FLRHW/Desk_controller/output/reports/Desk_controller-drc.html

Logo

(https://github.com/INTI-CMNB/KiBot/) | DRC report for Desk_controller
| PCB: Desk_controller Revision: 1.0.1 Date: 2026-10-25T19:02:43 KiCad Version: 10.0.5 | Errors: 0 Warnings: 4 Total: 4

Violations

Type | Description | Details
silk_over_copper | Silkscreen clipped by solder mask | @(197.425 mm, 77.976 mm): Segment of J6 on F.Silkscreen @(196.493 mm, 77.264 mm): Rectangle on F.Mask
silk_over_copper | Silkscreen clipped by solder mask | @(197.425 mm, 79.976 mm): Segment of J6 on F.Silkscreen @(196.493 mm, 77.264 mm): Rectangle on F.Mask
silk_over_copper | Silkscreen clipped by solder mask | @(186.925 mm, 79.976 mm): Segment of J6 on F.Silkscreen @(186.079 mm, 77.264 mm): Rectangle on F.Mask
silk_over_copper | Silkscreen clipped by solder mask | @(187.925 mm, 77.976 mm): Segment of J6 on F.Silkscreen @(186.079 mm, 77.264 mm): Rectangle on F.Mask

Generated by KiBot (https://github.com/INTI-CMNB/KiBot/) v1.9.1
