FLRHW/Desk_controller/output/reports/Desk_controller-erc.html

Logo

(https://github.com/INTI-CMNB/KiBot/) | ERC report for Desk_controller
| Schematic: Desk_controller Revision: 1.1.1 Date: 2026-10-25T19:02:39 KiCad Version: 10.0.5 | Errors: 0 Warnings: 0 Total: 0

✔

Generated by KiBot (https://github.com/INTI-CMNB/KiBot/) v1.9.1
