FLRHW/Desk_controller/output/3d/Desk_controller-3D_blenderbare_bottom.png

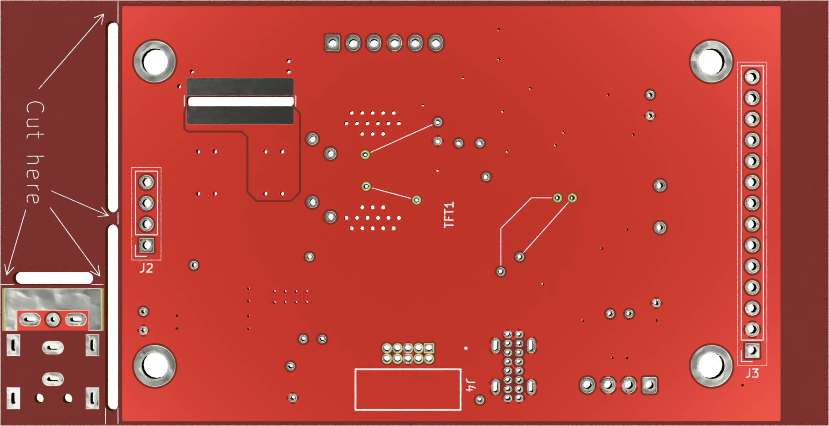
output/3d/Desk_controller-3D_blenderbare_bottom.png
