FLRHW/Desk_controller/output/3d/Desk_controller-3D_blenderbare_top.png

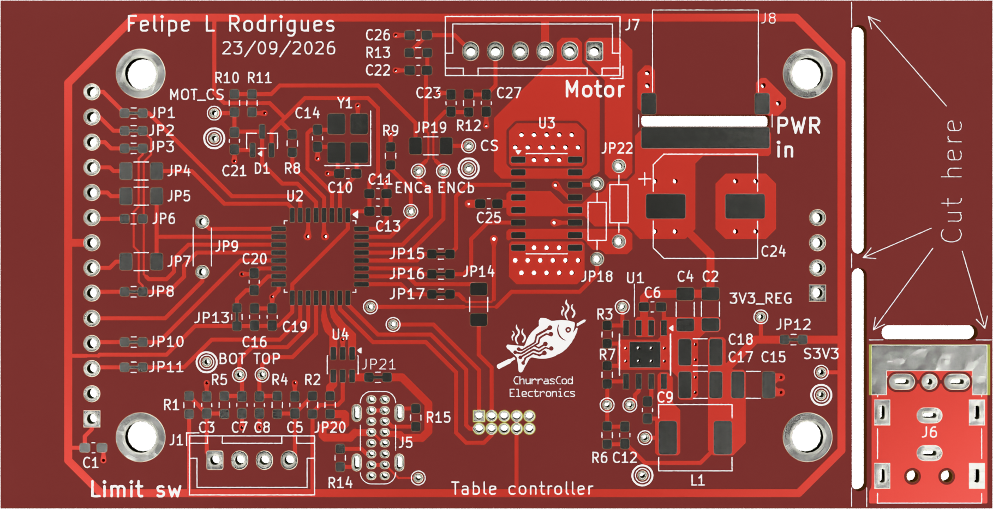
output/3d/Desk_controller-3D_blenderbare_top.png
