FLRHW/Desk_controller/output/3d/Desk_controller-3D_blenderbottom.png

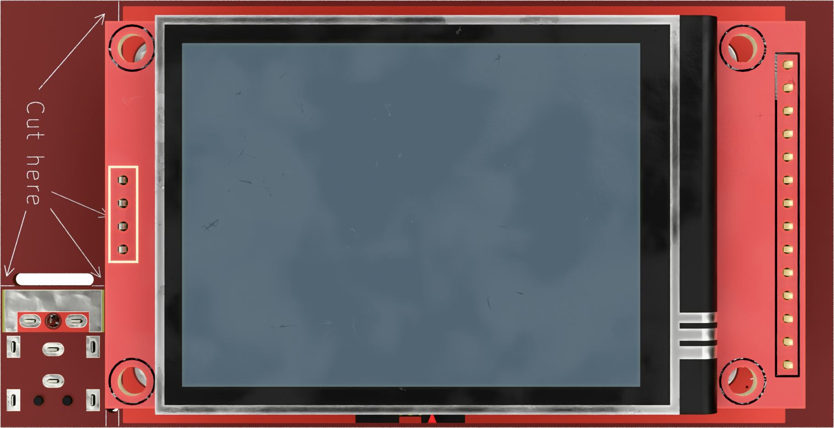
output/3d/Desk_controller-3D_blenderbottom.png
