FLRHW/Desk_controller/output/3d/Desk_controller-3D_blendertop.png

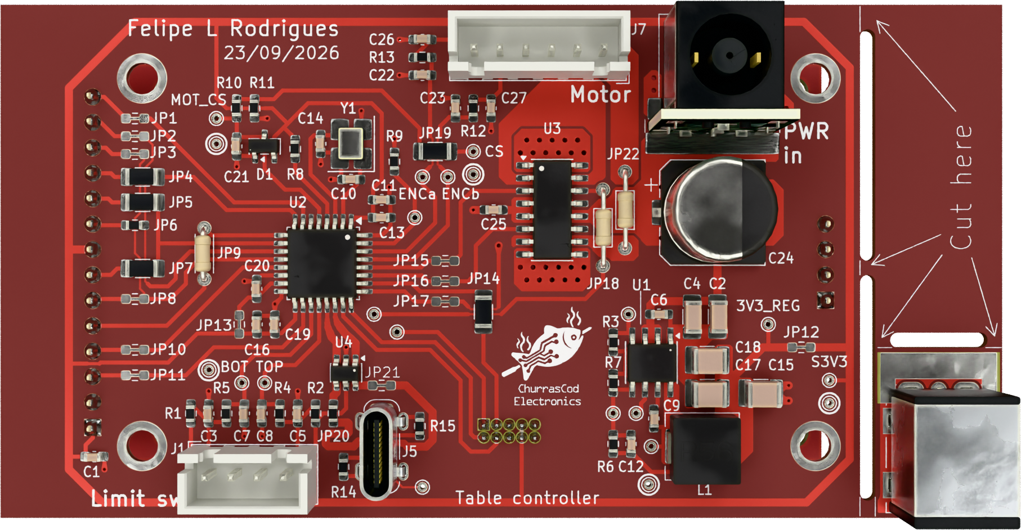
output/3d/Desk_controller-3D_blendertop.png
