FLRHW/Desk_controller/output/reports/browse/images/cat_blender_angled_bottom_Desk_controller-3D_blenderangled_bottom.png

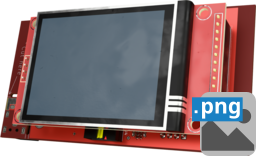
output/reports/browse/images/cat_blender_angled_bottom_Desk_controller-3D_blenderangled_bottom.png
