FLRHW/Desk_controller/output/reports/browse/images/cat_blender_bare_bottom_Desk_controller-3D_blenderbare_bottom.png

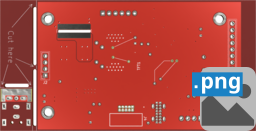
output/reports/browse/images/cat_blender_bare_bottom_Desk_controller-3D_blenderbare_bottom.png
