FLRHW/Desk_controller/output/reports/browse/images/cat_blender_bottom_Desk_controller-3D_blenderbottom.png

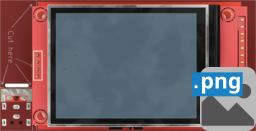
output/reports/browse/images/cat_blender_bottom_Desk_controller-3D_blenderbottom.png
