FLRHW/Desk_controller/output/reports/browse/images/cat_Schematic_Desk_controller-schematic.png

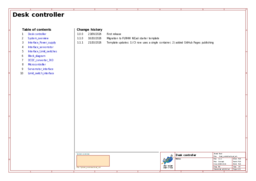
output/reports/browse/images/cat_Schematic_Desk_controller-schematic.png
