FLRHW/Desk_controller/output/reports/browse/images/cat_schematic_pdf_Desk_controller-schematic.png

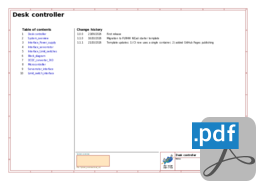
output/reports/browse/images/cat_schematic_pdf_Desk_controller-schematic.png
