FLRHW/Desk_controller/output/assembly/bom/Desk_controller-bom.xlsx

Sheet: BoM
 |  | KiBot Bill of Materials
 |  | Schematic: | Desk_controller | Component Groups: | 39
 |  | Variant: | default | Component Count: | 72
 |  | Revision: | 1.1.1 | Fitted Components: | 72
 |  | Date: | 21/10/2026 | Number of PCBs: | 1
 |  | KiCad Version: | 10.0.5-unknown-202607221313~667fa36054~ubuntu25.10.1 | Total Components: | 72
Row | Description | Part | References | Value | Footprint | Quantity Per PCB | Status | Datasheet | Manufacturer | Manufacturer Part Number | Assy | BarrelConn | Config | Field5
1 | Unpolarized capacitor | C | C10 C14 | 22p | C_0603_1608Metric_Pad1.08x0.95mm_HandSolder | 2 |  |  | Yageo | AC0603JRNPO9BN220
2 | Unpolarized capacitor | C | C12 | 33p | C_0603_1608Metric_Pad1.08x0.95mm_HandSolder | 1 |  |  | Yageo | AC0603JRNPO9BN330
3 | Unpolarized capacitor | C | C7 C8 C21 C22 C23 | 1n | C_0603_1608Metric_Pad1.08x0.95mm_HandSolder | 5 |  |  | Yageo | AC0603KRX7R9BB102
4 | Unpolarized capacitor | C | C3 C5 C26 C27 | 10n | C_0603_1608Metric_Pad1.08x0.95mm_HandSolder | 4 |  |  | Yageo | AC0603KRX7R9BB103
5 | Unpolarized capacitor | C | C1 C6 C9 C13 C19 C20 C25 | 100n | C_0603_1608Metric_Pad1.08x0.95mm_HandSolder | 7 |  |  | Yageo | AC0603KRX7R9BB104
6 | Unpolarized capacitor | C | C11 C16 | 1u | C_0603_1608Metric_Pad1.08x0.95mm_HandSolder | 2 |  |  | Yageo | AC0603KRX7R7BB105
7 | Unpolarized capacitor | C | C2 C4 | 4.7u | C_1206_3216Metric_Pad1.33x1.80mm_HandSolder | 2 |  |  | KEMET | C1206C475K5RACAUTO
8 | Unpolarized capacitor | C | C15 C17 C18 | 22u | C_1210_3225Metric_Pad1.33x2.70mm_HandSolder | 3 |  |  | TAIYO YUDEN | MCAST32MSB7226KPNA01
9 | Polarized capacitor | C_Polarized | C24 | 220u | CP_Elec_10x10 | 1 |  |  | Panasonic | EEE-FK1H221P
10 | BAV99 High-speed switching diodes, SOT-23 | BAV99 | D1 | BAV99 | SOT-23 | 1 |  | https://assets.nexperia.com/documents/data-sheet/BAV99_SER.pdf | Diodes Inc | BAV99Q-7-F
11 | Generic connector, single row, 01x04, script generated | Conn_01x04_Pin | J2 | 01x04 socket | PinSocket_1x04_P2.54mm_Vertical | 1 |  |  | Generic | Generic
12 | Generic connector, single row, 01x14, script generated | Conn_01x14_Pin | J3 | 01x14 socket | PinSocket_1x14_P2.54mm_Vertical | 1 |  |  | Generic | Generic
13 | Generic connector, single row, 01x04, script generated | Conn_01x04_Pin | J1 | B4B XH A | JST_XH_B4B-XH-A_1x04_P2.50mm_Vertical | 1 |  |  | JST | B4B XH A
14 | Generic connector, single row, 01x06, script generated | Conn_01x06_Pin | J7 | B6B XH A | JST_XH_B6B-XH-A_1x06_P2.50mm_Vertical | 1 |  |  | JST | B6B XH A
15 |  | DC_barrel_assy | J8 | DC barrel assy | Dell_barrel_assy | 1 |  |  | NA | NA
16 |  | Dell_DC_barrel_jack | J6 | Dell DC jack | Dell DC jack | 1 |  |  | Dell | Barrel jack
17 | Generic connector, double row, 02x05, odd/even pin numbering scheme (row 1 odd numbers, row 2 even numbers), script generated (kicad-library-utils/schlib/autogen/connector/) | Conn_02x05_Odd_Even | J4 | HX JN1.27-2x5 WZ H4.9 | JN1.27-2x5 WZ H4.9 | 1 |  |  | Hanxia | HX JN1.27-2x5 WZ H4.9 |  |  |  | https://www.lcsc.com/product-detail/IDC-Connectors_hanxia-HX-JN1-27-2x5-WZ-H4-9_C42372551.html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
18 | USB 2.0-only 16P Type-C Receptacle connector | USB_C_Receptacle_USB2.0_16P | J5 | USB_C_Receptacle_USB2.0_16P | USB_C_socket_16P_vertical | 1 |  | https://www.usb.org/sites/default/files/documents/usb_type-c.zip | ChengHaoRan | TFKH5-16L4CC-65
19 | Jumper | R | JP4 JP5 JP7 JP14 JP19 | 0R | R_1206_3216Metric_Pad1.30x1.75mm_HandSolder | 5 |  |  | NA | Hand cut wire
20 | Jumper | R | JP18 JP22 | 0R | R_Axial_DIN0204_L3.6mm_D1.6mm_P7.62mm_Horizontal | 2 |  |  | NA | Hand cut wire
21 | Jumper | R | JP6 JP20 | 0R | R_0603_1608Metric_Pad0.98x0.95mm_HandSolder | 2 |  |  | Yageo | RC0603JR-130RP
22 | Jumper | R | JP23 | 0R | Wire_9.603mm | 1 |  |  | NA | Hand cut wire
23 | Jumper | R | JP24 | 0R | Wire_6.310mm | 1 |  |  | NA | Hand cut wire
24 | Jumper | R | JP25 | 0R | Wire_9.532mm | 1 |  |  | NA | Hand cut wire
25 | Jumper | R | JP26 | 0R | Wire_6.853x8.890mm | 1 |  |  | NA | Hand cut wire
26 | Jumper | R | JP9 | 0R | R_Axial_DIN0204_L3.6mm_D1.6mm_P5.08mm_Horizontal | 1 |  |  | NA | Hand cut wire
27 | Inductor | L | L1 | 10u | L_Bourns_SRP6540 | 1 |  |  | Bourns | SRP6540-100M
28 | Resistor | R | R11 | 820 | R_0603_1608Metric_Pad0.98x0.95mm_HandSolder | 1 |  |  | YAGEO | AC0603FR-07820RL
29 | Resistor | R | R4 R5 R10 R12 R13 | 2k2 | R_0603_1608Metric_Pad0.98x0.95mm_HandSolder | 5 |  |  | YAGEO | AC0603FR-072K2L
30 | Resistor | R | R14 R15 | 5k1 | R_0603_1608Metric_Pad0.98x0.95mm_HandSolder | 2 |  |  | YAGEO | AC0603FR-075K1L
31 | Resistor | R | R1 R2 R7 R8 R9 | 10k | R_0603_1608Metric_Pad0.98x0.95mm_HandSolder | 5 |  |  | YAGEO | AC0603FR-0710KL
32 | Resistor | R | R6 | 23.2k | R_0603_1608Metric_Pad0.98x0.95mm_HandSolder | 1 |  |  | YAGEO | AC0603FR-0723K2L
33 | Resistor | R | R3 | 64.9k | R_0603_1608Metric_Pad0.98x0.95mm_HandSolder | 1 |  |  | YAGEO | AC0603FR-0764K9L
34 |  | TFT_2.8_IN_320x240 | TFT1 | TFT_2.4in_320x240 | Display_240x320_ILI9341_2.4in_no_pads | 1 |  |  | TENSTAR ROBOT | ILI9341_320x240
35 |  | LMR380x0 | U1 | LMR380x0 | Texas_HSOP-8-1EP_3.9x4.9mm_P1.27mm_ThermalVias_w_step | 1 |  |  | Texas instruments | LMR38020FDDAR
36 | STMicroelectronics Arm Cortex-M4 MCU, 64KB flash, 32KB RAM, 170 MHz, 1.71-3.6V, 26 GPIO, LQFP32 | STM32G431K8Tx | U2 | STM32G431K8T | LQFP-32_7x7mm_P0.8mm | 1 |  | https://www.st.com/resource/en/datasheet/stm32g431k8.pdf | ST | STM32G431K8T6
37 | Very low capacitance ESD protection diode, 2 data-line, SOT-23-6 | USBLC6-2SC6 | U4 | USBLC6-2SC6 | SOT-23-6 | 1 |  | https://www.st.com/resource/en/datasheet/usblc6-2.pdf | ST | USBLC6-2SC6
38 |  | VNH7070 | U3 | VNH7070 | JEITA_SOIC-16_3.9x9.9mm_P1.27mm | 1 |  |  | ST | VNH7070
39 | Four pin crystal, GND on pins 2 and 4, small symbol | Crystal_GND24_Small | Y1 | 20 MHz | Crystal_SMD_3225-4Pin_3.2x2.5mm_HandSoldering | 1 |  |  | KYOCERA AVX | CX3225SB20000H0FLJCC

Sheet: Colors
Columns colors
KiCad Fields (default)
Generated Fields
User Fields
Empty Fields
