FLRHW/Desk_controller/output/3d/Desk_controller-3D.step

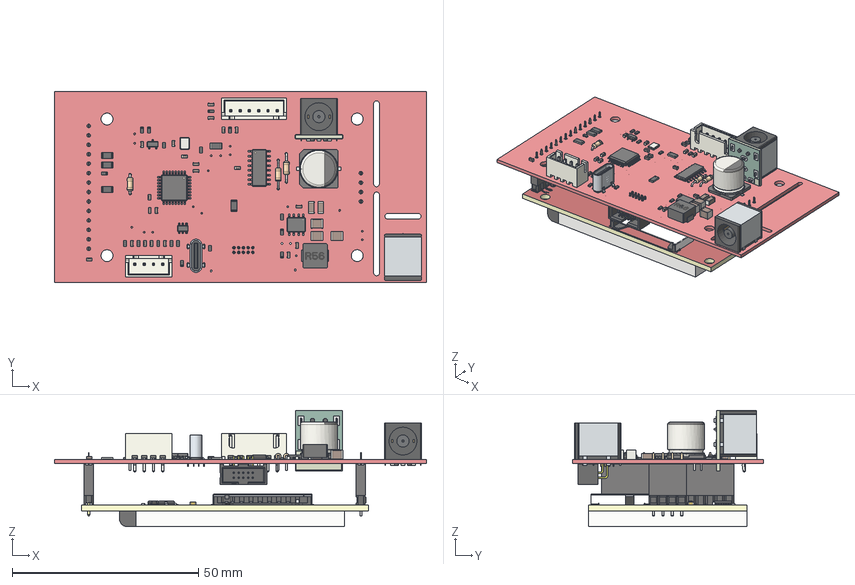
[picture p18: CAD file, 2026-10-25]
output/3d/Desk_controller-3D.step
100.0 x 51.2 x 31.2 mm
R_1206_3216Metric x 5
C_0603_1608Metric x 21
R_0603_1608Metric x 17
C_1210_3225Metric x 3
black_plastic_body x 2
contiguous_stamped_shield_and_four_stakes x 2
plastic_centre_boss_with_ID_hole x 2
barrel_side_contact_1 x 2
barrel_side_contact_2 x 2
pad1_terminal_1_x-2.775_y12.25 x 2
pad1_terminal_2_x2.775_y12.25 x 2
pad2_terminal_3_x0_y12.25 x 2
pad3_terminal_4_x0_y8.85 x 2
pad3_terminal_5_x0_y5.05 x 2
plastic_peg_1 x 2
plastic_peg_2 x 2
SOT-23-6
JST_B4B_XH_A
Texas_HTSOP_8_1EP_39x49mm_P127mm_EP285x49mm_Mask24x31mm_ThermalVias
R_Axial_DIN0204_L36mm_D16mm_P762mm_Horizontal x 2
SOP-16_3.9x9.9mm_P1.27mm
C_1206_3216Metric x 2
Crystal_SMD_3225-4Pin_3.2x2.5mm
SOT-23
CP_Elec_10x10
R_Axial_DIN0204_L36mm_D16mm_P508mm_Horizontal
Barrel-unsaved-export-6gLF2A_pad
Barrel-unsaved-export-6gLF2A_silkscreen
Barrel-unsaved-export-6gLF2A_soldermask x 2
Barrel-unsaved-export-6gLF2A_PCB
SRP6540
JST_B6B_XH_A
stainless_shell
black_LCP_body_and_tongue
contact_r1_c1
contact_r1_c2
contact_r1_c3
contact_r1_c4
contact_r1_c5
contact_r1_c6
contact_r1_c7
contact_r1_c8
contact_r2_c1
contact_r2_c2
contact_r2_c3
contact_r2_c4
contact_r2_c5
contact_r2_c6
contact_r2_c7
contact_r2_c8
mating_contact_A1
mating_contact_A2
mating_contact_A3
mating_contact_A4
mating_contact_A5
mating_contact_A6
mating_contact_A7
mating_contact_A8
mating_contact_A9
mating_contact_A10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
