FLRHW/Desk_controller/output/fabrication/Desk_controller-pcb-fabrication.pdf

# Desk controller fabrication drawing

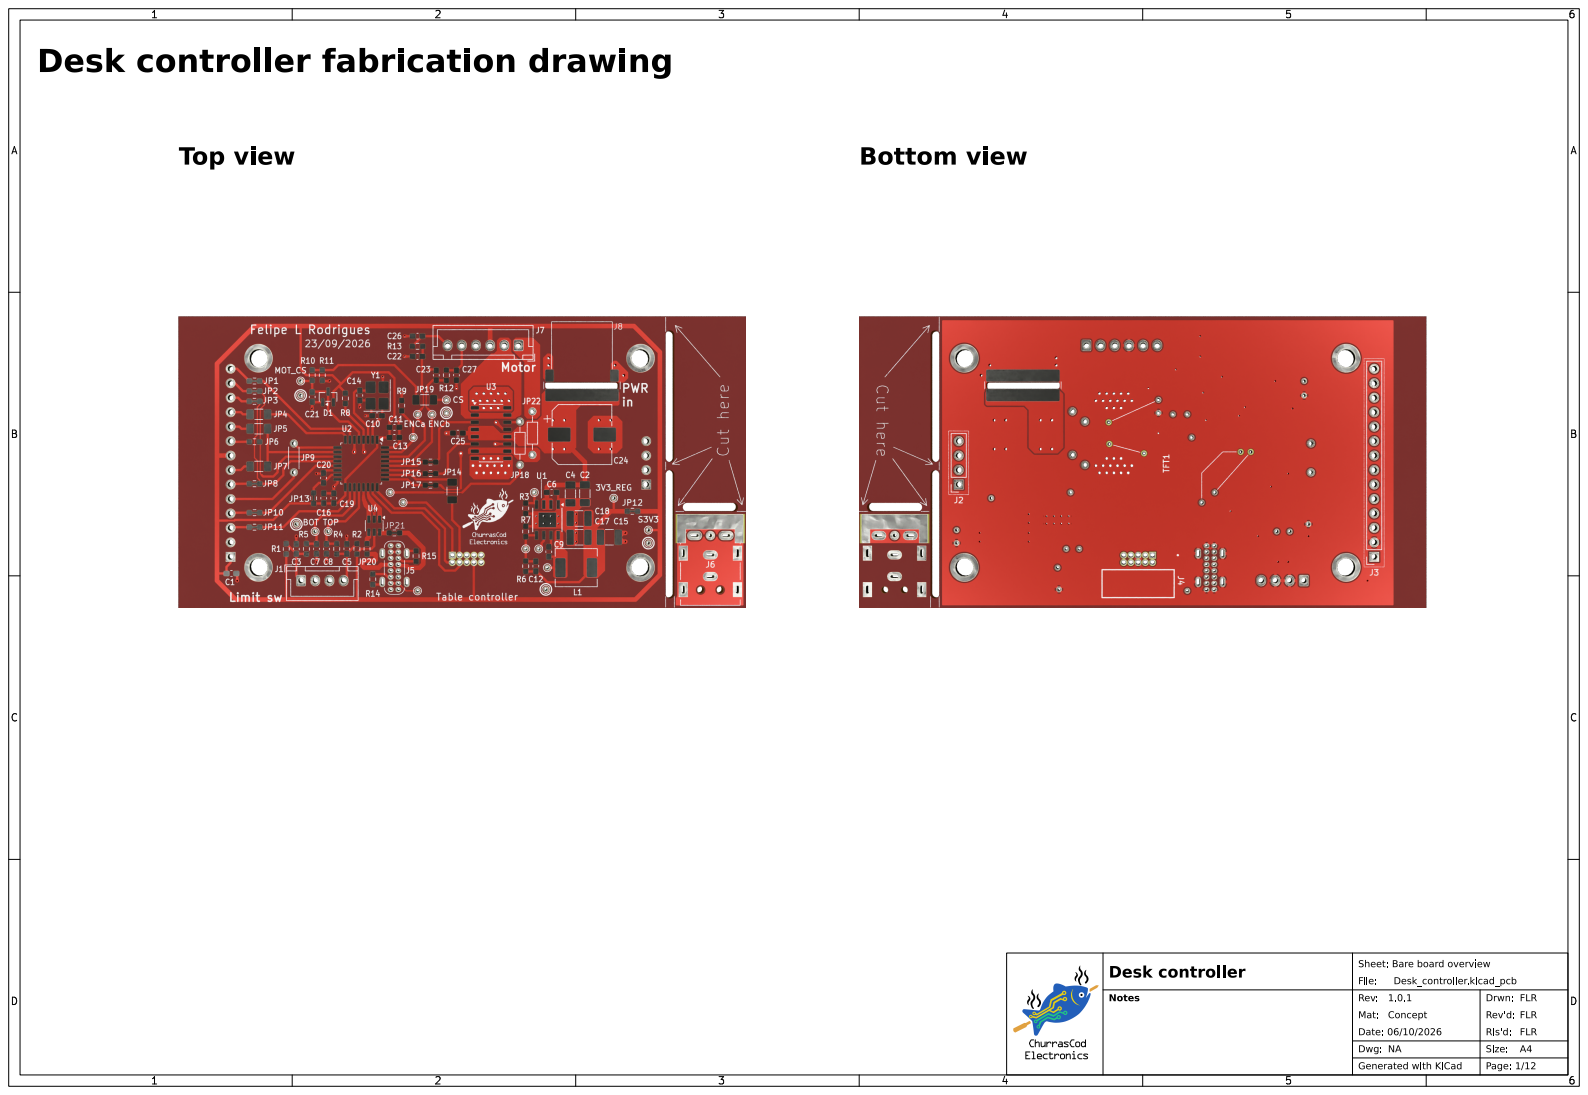
[picture p26: page 1]
Desk_controller.kicad_pcb; FLR; Rev'd:; Drwn:; Desk controller; Rls'd:; Concept; Notes; Size:

Sheet: Bare board overview
File:
Rev:
Mat:
Date: 06/10/2026
Dwg: NA
Generated with KiCad

# Fabrication requirements

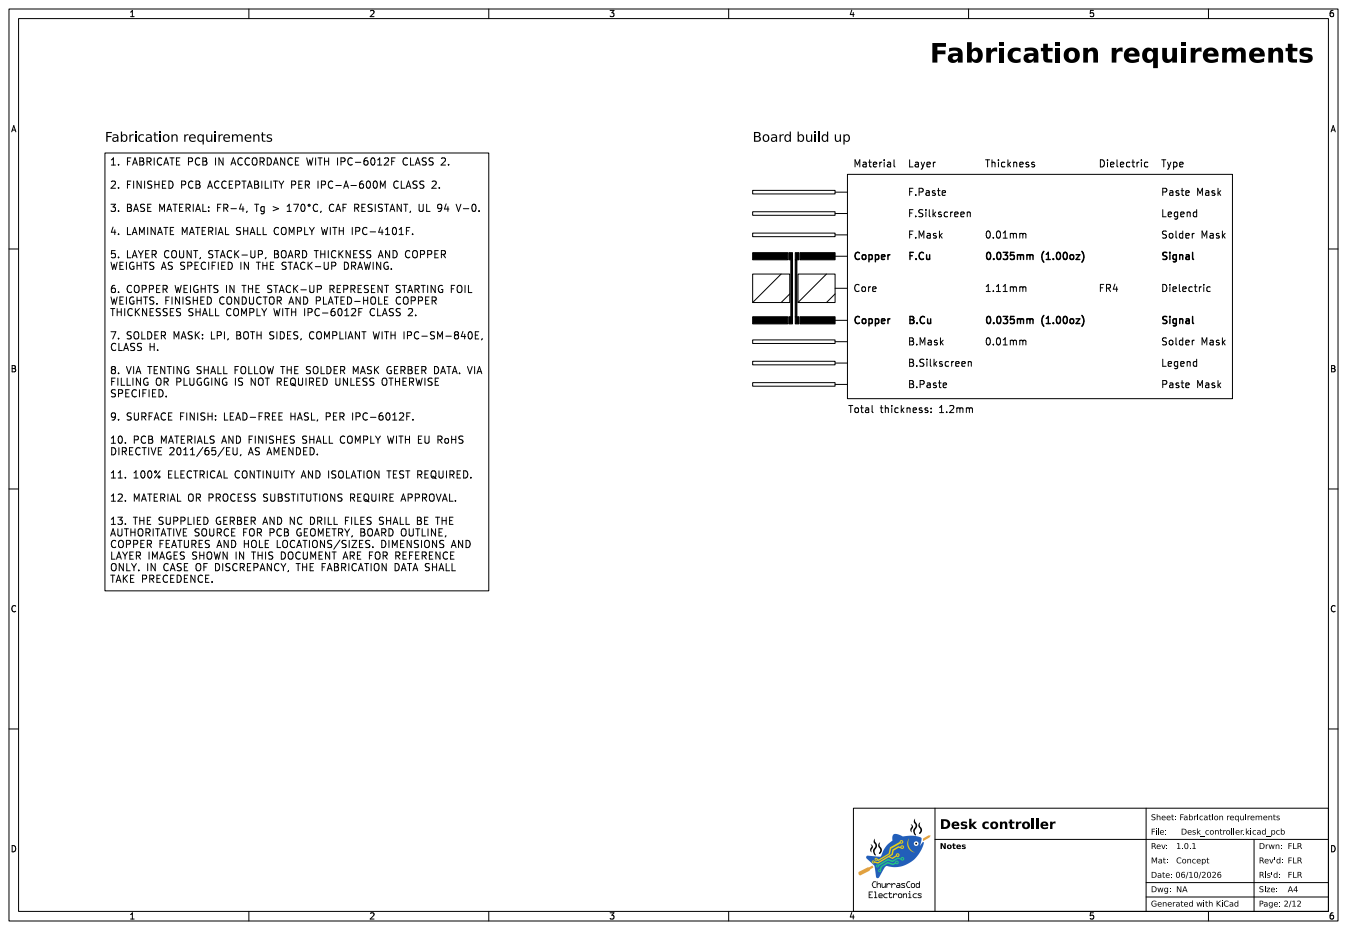
[picture p27: page 2]
Mat:; Desk_controller.kicad_pcb; FLR; Rev'd:; Drwn:; Desk controller; Rls'd:; Concept; Notes; Sheet: Fabrication requirements; File:; Rev:; Date: 06/10/2026; CLASS H.; 7. SOLDER; MASK:; LPI,; BOTH; SIDES, COMPLIANT; WITH; IPC-SM-840E,; THICKNESSES SHALL; COMPLY; IPC-6012F CLASS 2.; WEIGHTS. FINISHED; CONDUCTOR; AND PLATED-HOLE; COPPER; 6. COPPER; WEIGHTS; THE; STACK-UP REPRESENT; STARTING; FOIL; WEIGHTS AS SPECIFIED; STACK-UP DRAWING.; LAYER COUNT,; STACK-UP,; BOARD THICKNESS; AND COPPER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

8. VIA TENTING SHALL FOLLOW THE SOLDER MASK GERBER DATA. VIA
FILLING OR PLUGGING IS NOT REQUIRED UNLESS OTHERWISE
SPECIFIED.

9. SURFACE FINISH: LEAD-FREE HASL, PER IPC-6012F.

10. PCB MATERIALS AND FINISHES SHALL COMPLY WITH EU RoHS
DIRECTIVE 2011/65/EU, AS AMENDED.

11. 100% ELECTRICAL CONTINUITY AND ISOLATION TEST REQUIRED.

12. MATERIAL OR PROCESS SUBSTITUTIONS REQUIRE APPROVAL.

13. THE SUPPLIED GERBER AND NC DRILL FILES SHALL BE THE
AUTHORITATIVE SOURCE FOR PCB GEOMETRY, BOARD OUTLINE,
COPPER FEATURES AND HOLE LOCATIONS/SIZES. DIMENSIONS AND
LAYER IMAGES SHOWN IN THIS DOCUMENT ARE FOR REFERENCE
ONLY. IN CASE OF DISCREPANCY, THE FABRICATION DATA SHALL
TAKE PRECEDENCE.

# Top fabrication (scale 1:1)

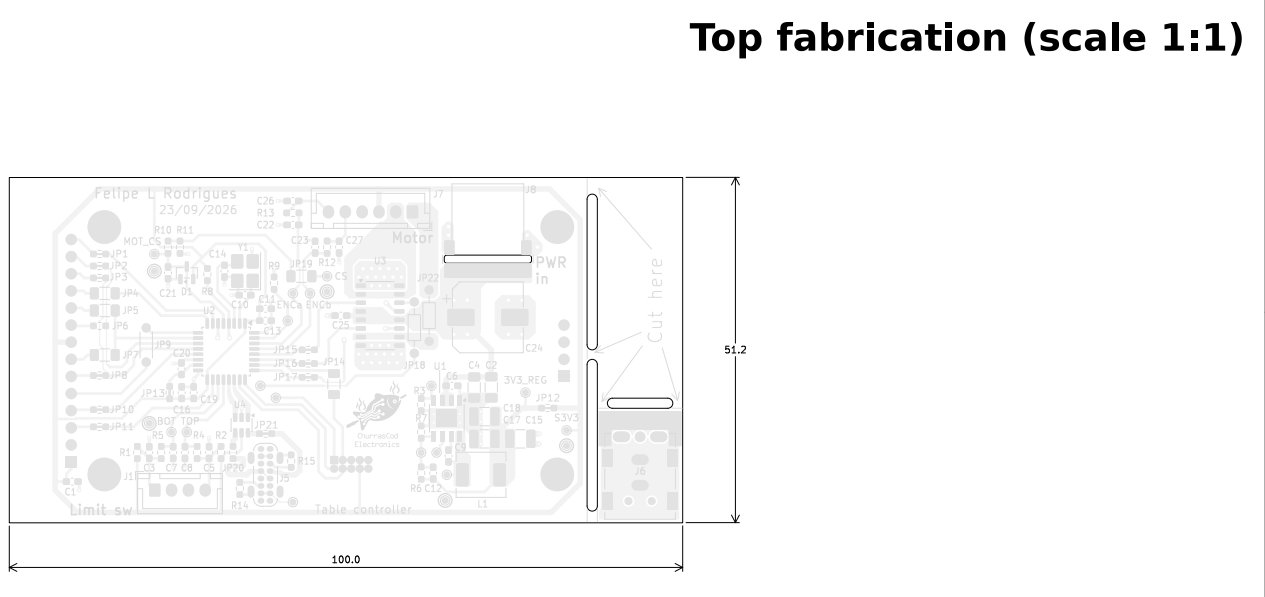
[picture p28: page 3]

# Bottom fabrication (scale 1:1)

# R 0.4 mm x 4 TFT1

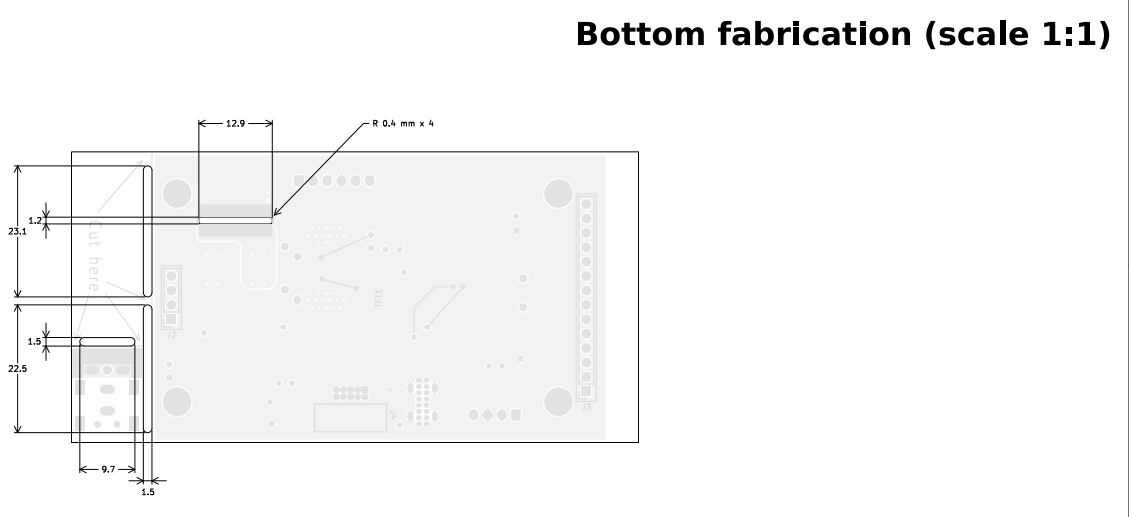
[picture p29: page 4]
Mat:; Desk_controller.kicad_pcb; FLR; Rev'd:; Drwn:; Desk controller; Rls'd:; Concept; Notes; Sheet: Bottom fabrication (scale 1:1); File:; Rev:; Date: 06/10/2026; Cut here

# Drill drawing — L1 - L2 (scale 1:1)

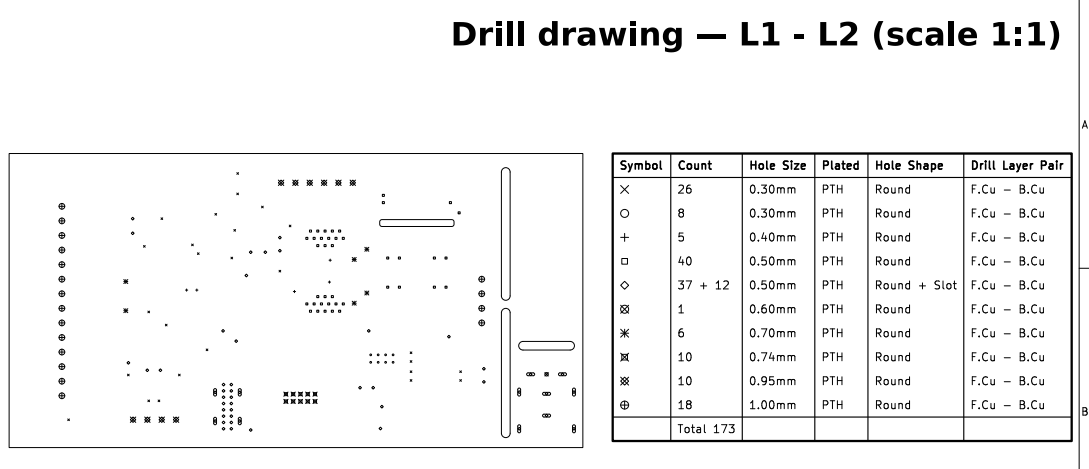
[picture p30: page 5]
Mat:; Desk_controller.kicad_pcb; FLR; Rev'd:; Drwn:; Desk controller; Rls'd:; Concept; Notes; Sheet: Drill drawing — L1 - L2 (scale 1:1); File:; Rev:; Date: 06/10/2026; Symbol; Count; Hole Size; Plated; Hole Shape; Drill Layer Pair; Total 173; PTH; Round; Round + Slot

# Drill drawing — L1 - L2 (scale 1:1)

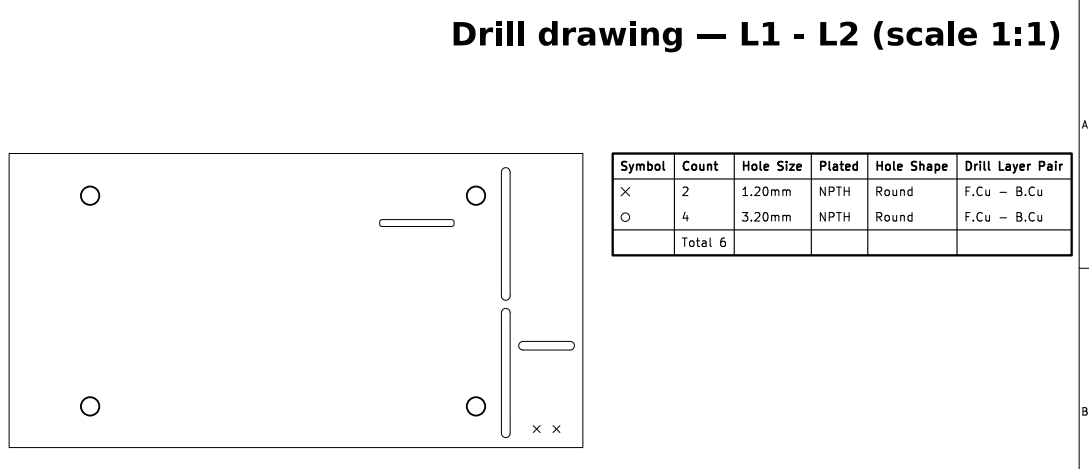
[picture p31: page 6]
Mat:; Desk_controller.kicad_pcb; FLR; Rev'd:; Drwn:; Desk controller; Rls'd:; Concept; Notes; Sheet: Drill drawing — L1 - L2 (scale 1:1); File:; Rev:; Date: 06/10/2026; Symbol; Count; Hole Size; Plated; Hole Shape; Drill; Layer; Pair; Total 6; NPTH; Round

# F.Cu (scale 1:1)

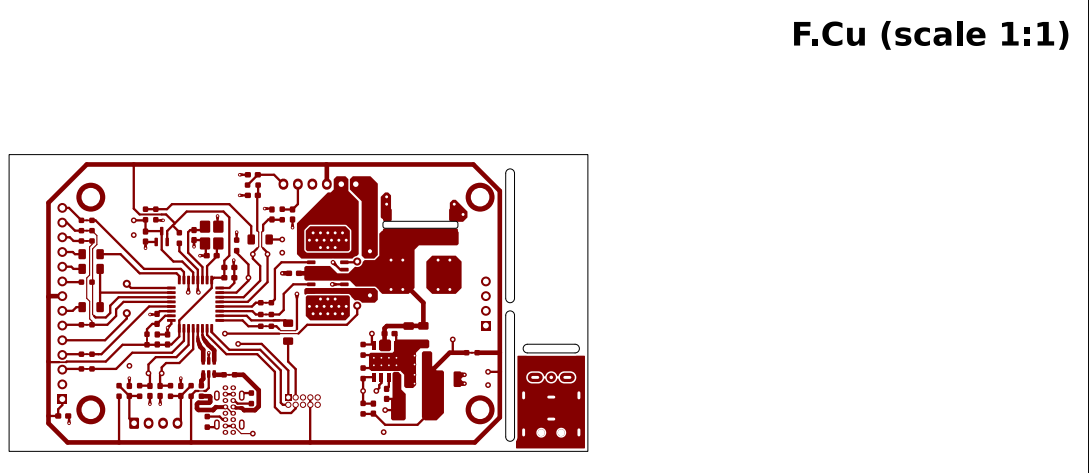
[picture p32: page 7]
Mat:; Desk_controller.kicad_pcb; FLR; Rev'd:; Drwn:; Desk controller; Rls'd:; Concept; Notes; Sheet: F.Cu (scale 1:1); File:; Rev:; Date: 06/10/2026

# B.Cu (scale 1:1)

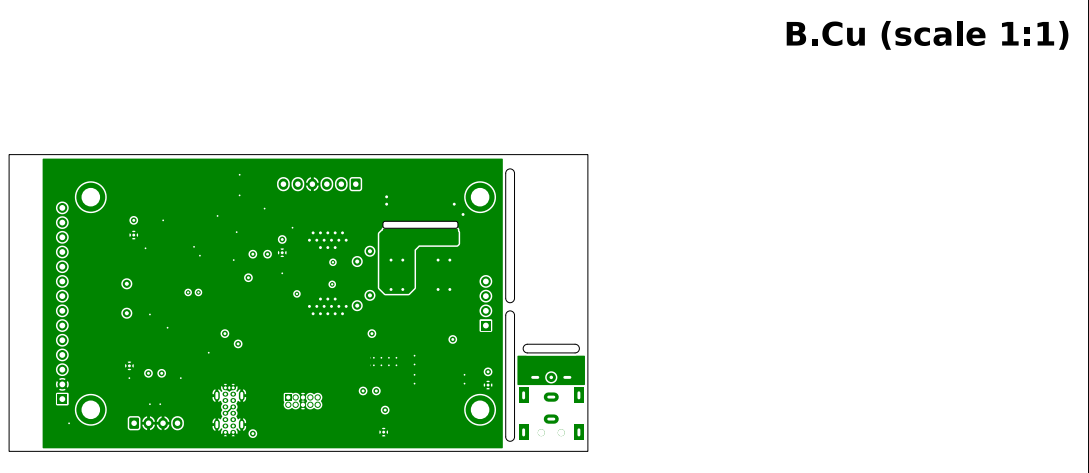
[picture p33: page 8]
Mat:; Desk_controller.kicad_pcb; FLR; Rev'd:; Drwn:; Desk controller; Rls'd:; Concept; Notes; Sheet: B.Cu (scale 1:1); File:; Rev:; Date: 06/10/2026

# F.Mask (scale 1:1)

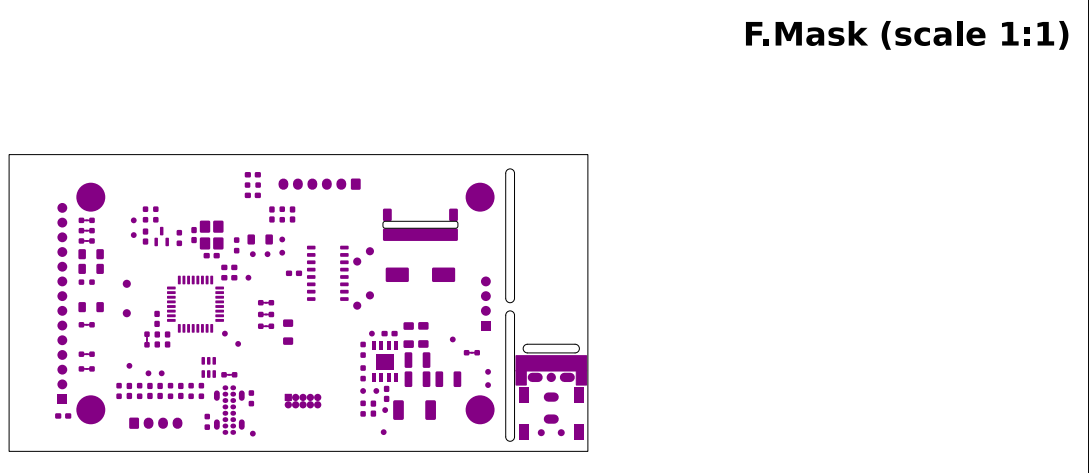
[picture p34: page 9]
Mat:; Desk_controller.kicad_pcb; FLR; Rev'd:; Drwn:; Desk controller; Rls'd:; Concept; Notes; Sheet: F.Mask (scale 1:1); File:; Rev:; Date: 06/10/2026

# B.Mask (scale 1:1)

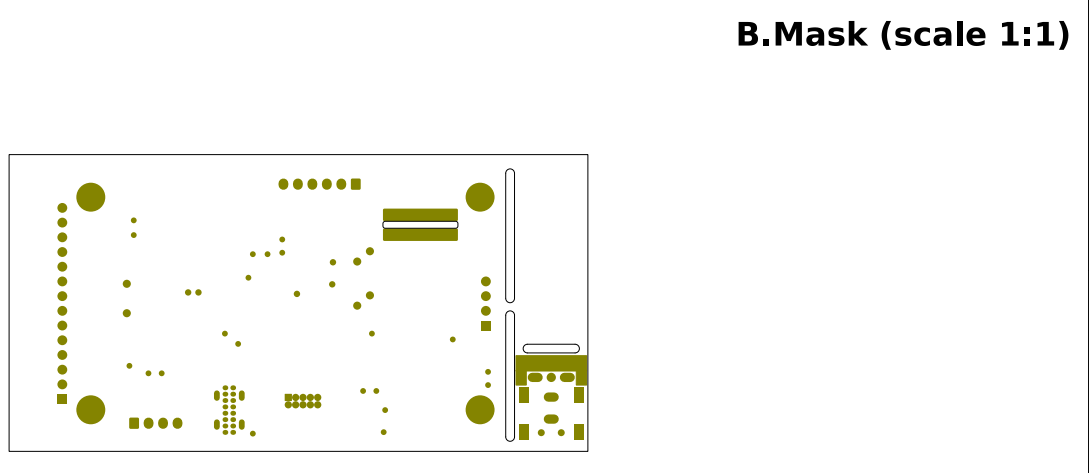
[picture p35: page 10]
Mat:; Desk_controller.kicad_pcb; FLR; Rev'd:; Drwn:; Desk controller; Rls'd:; Concept; Notes; Sheet: B.Mask (scale 1:1); File:; Rev:; Date: 06/10/2026

# F.Silkscreen (scale 1:1)

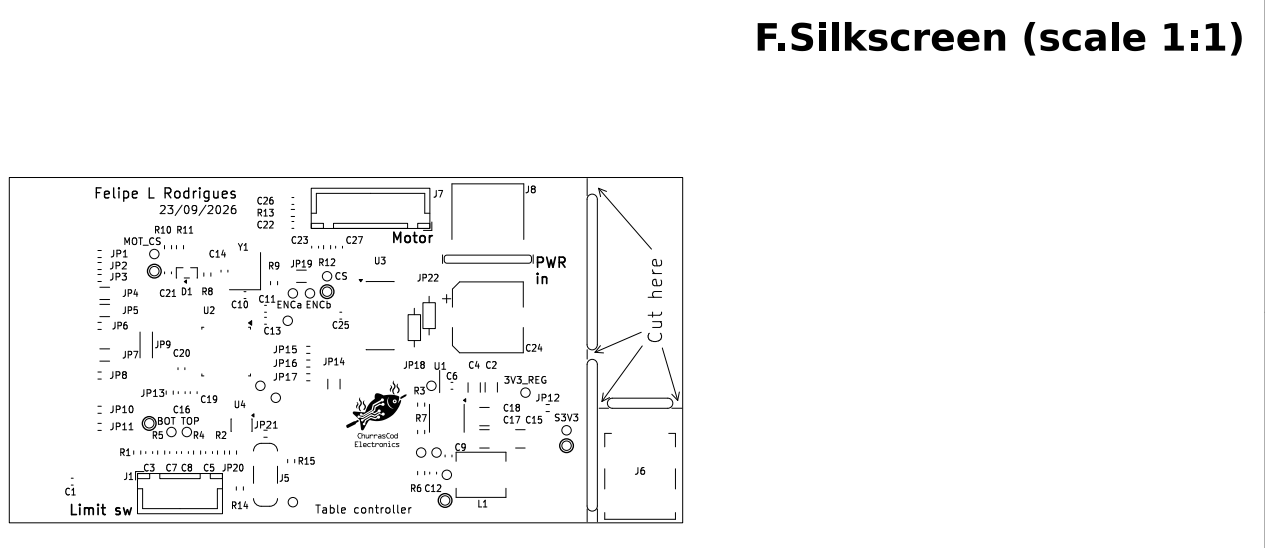
[picture p36: page 11]

# B.Silkscreen (scale 1:1)

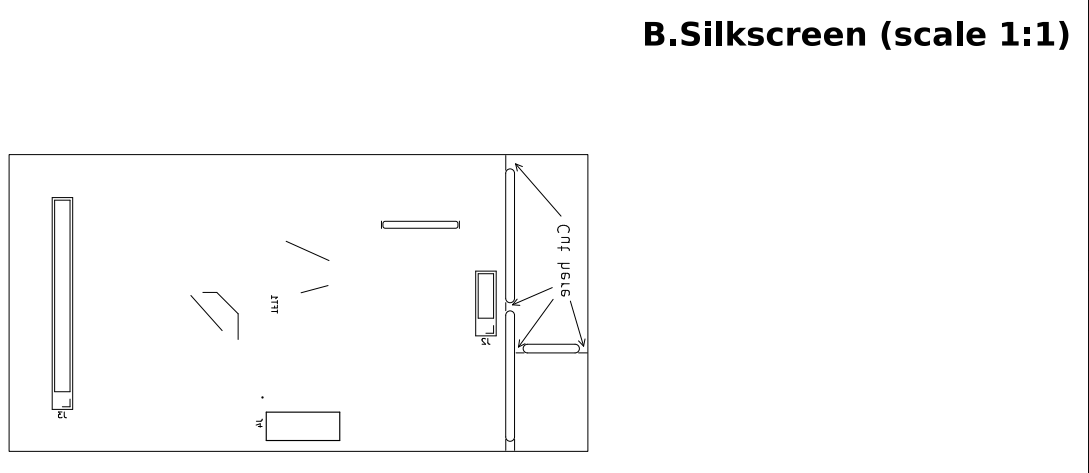
[picture p37: page 12]
Mat:; Desk_controller.kicad_pcb; FLR; Rev'd:; Drwn:; Desk controller; Rls'd:; Concept; Notes; Sheet: B.Silkscreen (scale 1:1); File:; Rev:; Date: 06/10/2026; 6 TFT1; Cut here
