FLRHW/Desk_controller/output/reports/browse/images/cat_pcb_assembly_pdf_Desk_controller-pcb-assembly.png

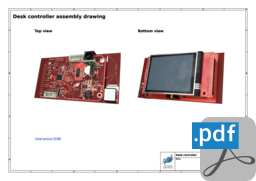
output/reports/browse/images/cat_pcb_assembly_pdf_Desk_controller-pcb-assembly.png
