FLRHW/Desk_controller/output/reports/browse/images/cat_PCB_Desk_controller-pcb-fabrication.png

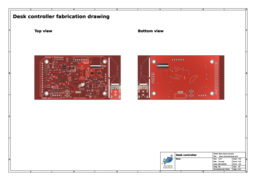
output/reports/browse/images/cat_PCB_Desk_controller-pcb-fabrication.png
