FLRHW/Desk_controller/output/reports/browse/images/cat_testpoints_pdf_Desk_controller-testpoints.png

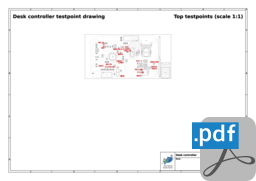
output/reports/browse/images/cat_testpoints_pdf_Desk_controller-testpoints.png
