FLRHW/Desk_controller/output/Desk_controller-schematic.pdf

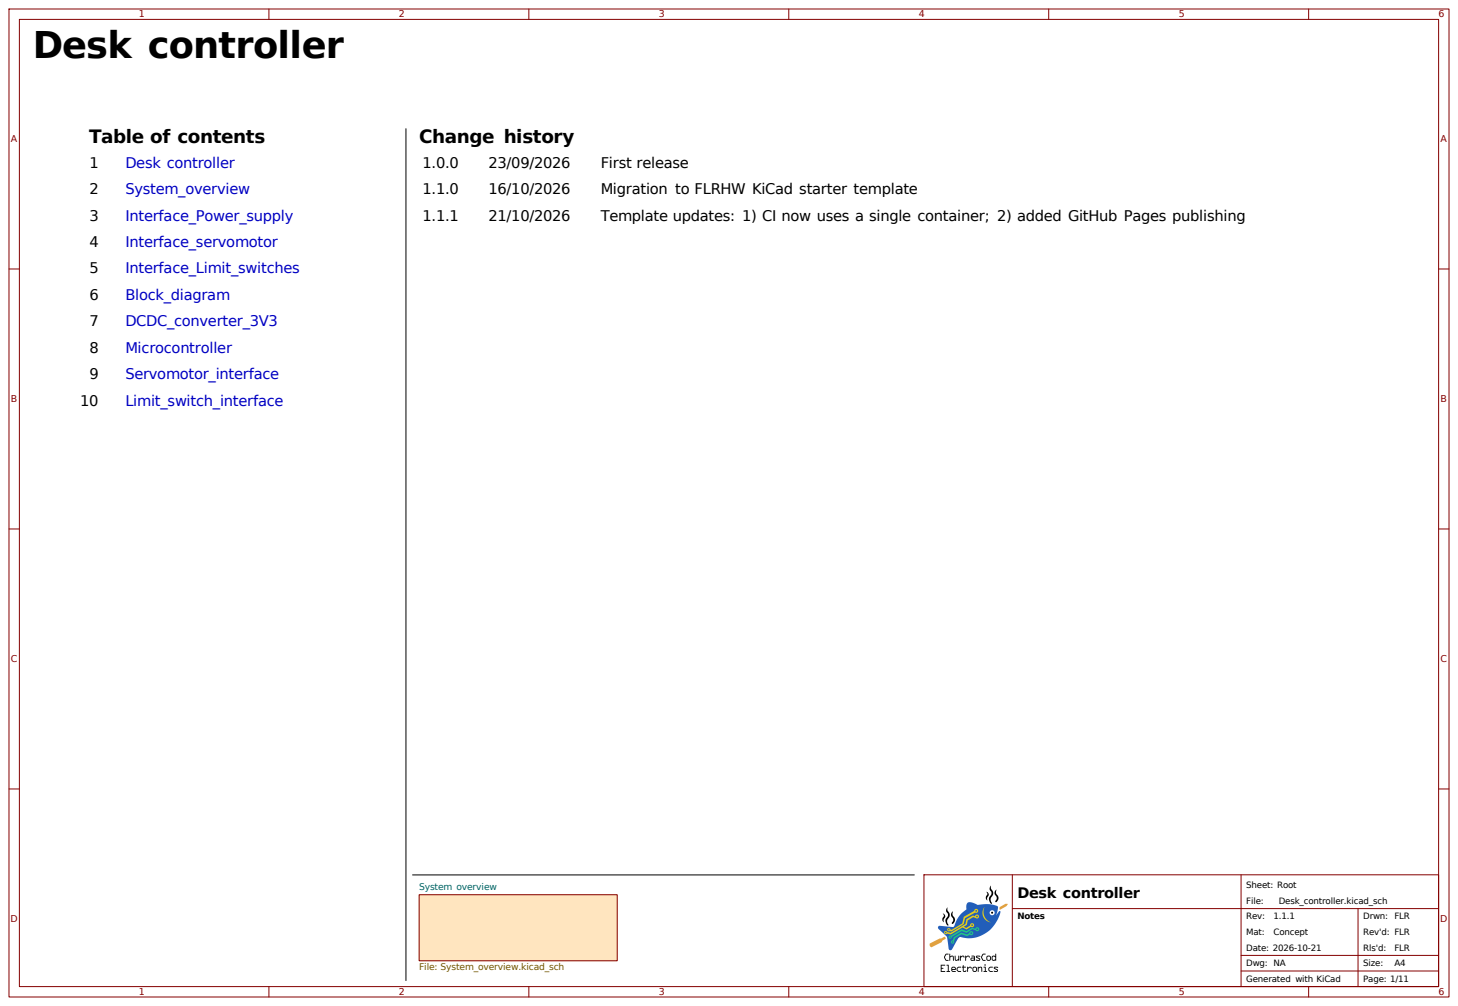
[picture p43: page 1]

First release
Migration to FLRHW KiCad starter template
Template updates: 1) CI now uses a single container; 2) added GitHub Pages publishing

Drwn: Rev'd: FLR Desk_controller.kicad_sch Dwg: NA

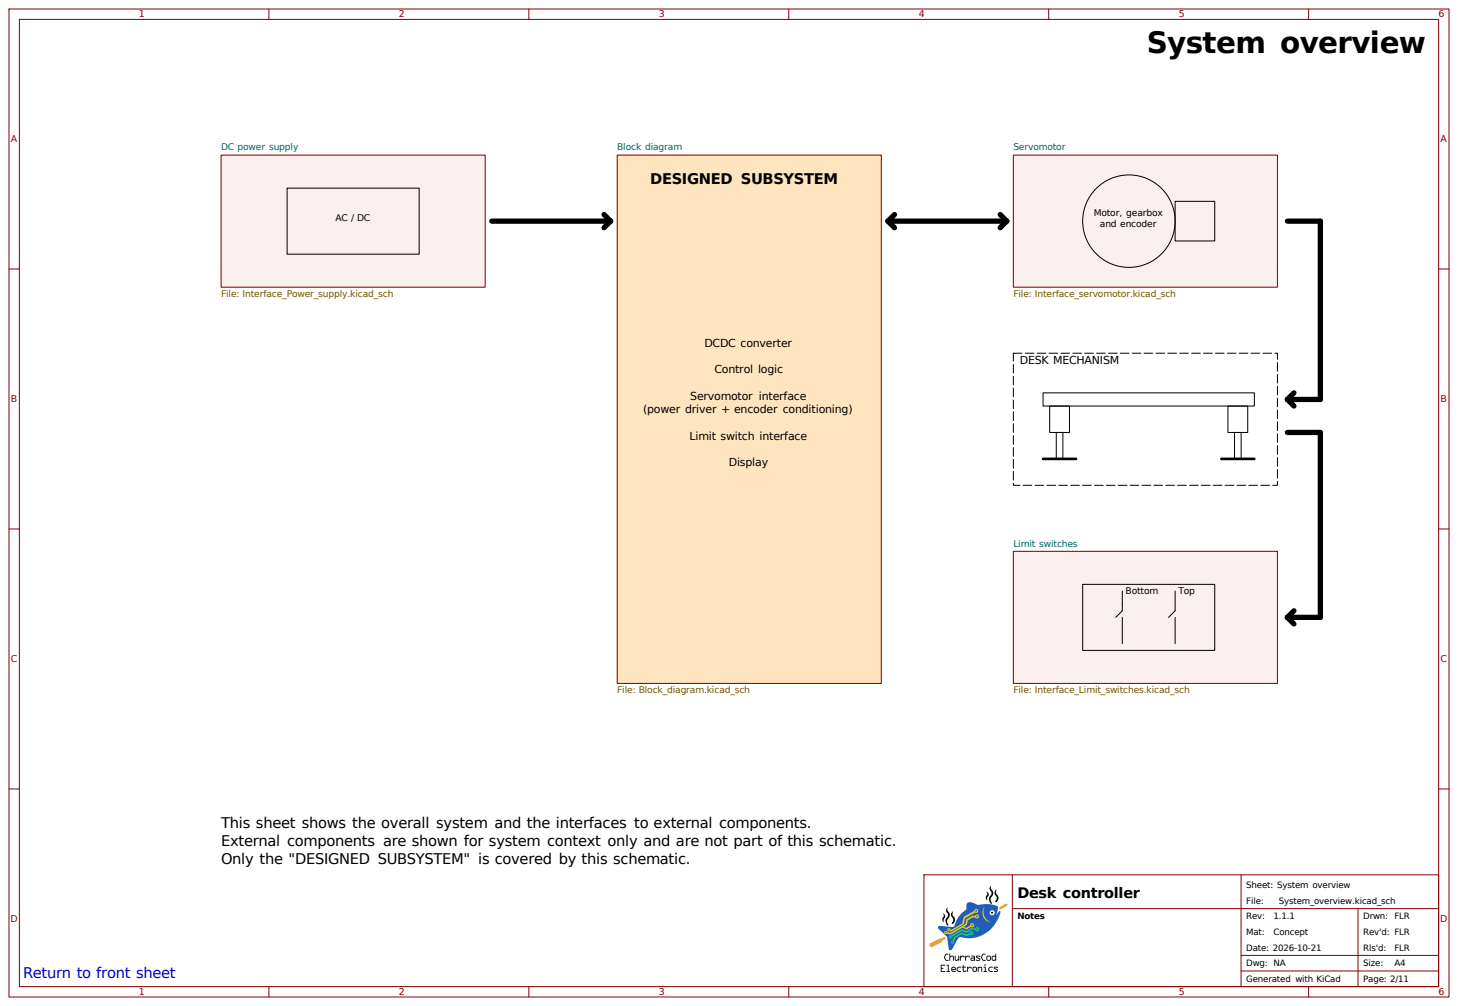
[picture p44: page 2]

Top Motor, gearbox and encoder DESK MECHANISM

Servomotor File: Interface_servomotor.kicad_sch DC power supply

AC / DC This sheet shows the overall system and the interfaces to external components.

DCDC converter Control logic

(power driver + encoder conditioning)

External components are shown for system context only and are not part of this schematic.

Return to front sheet

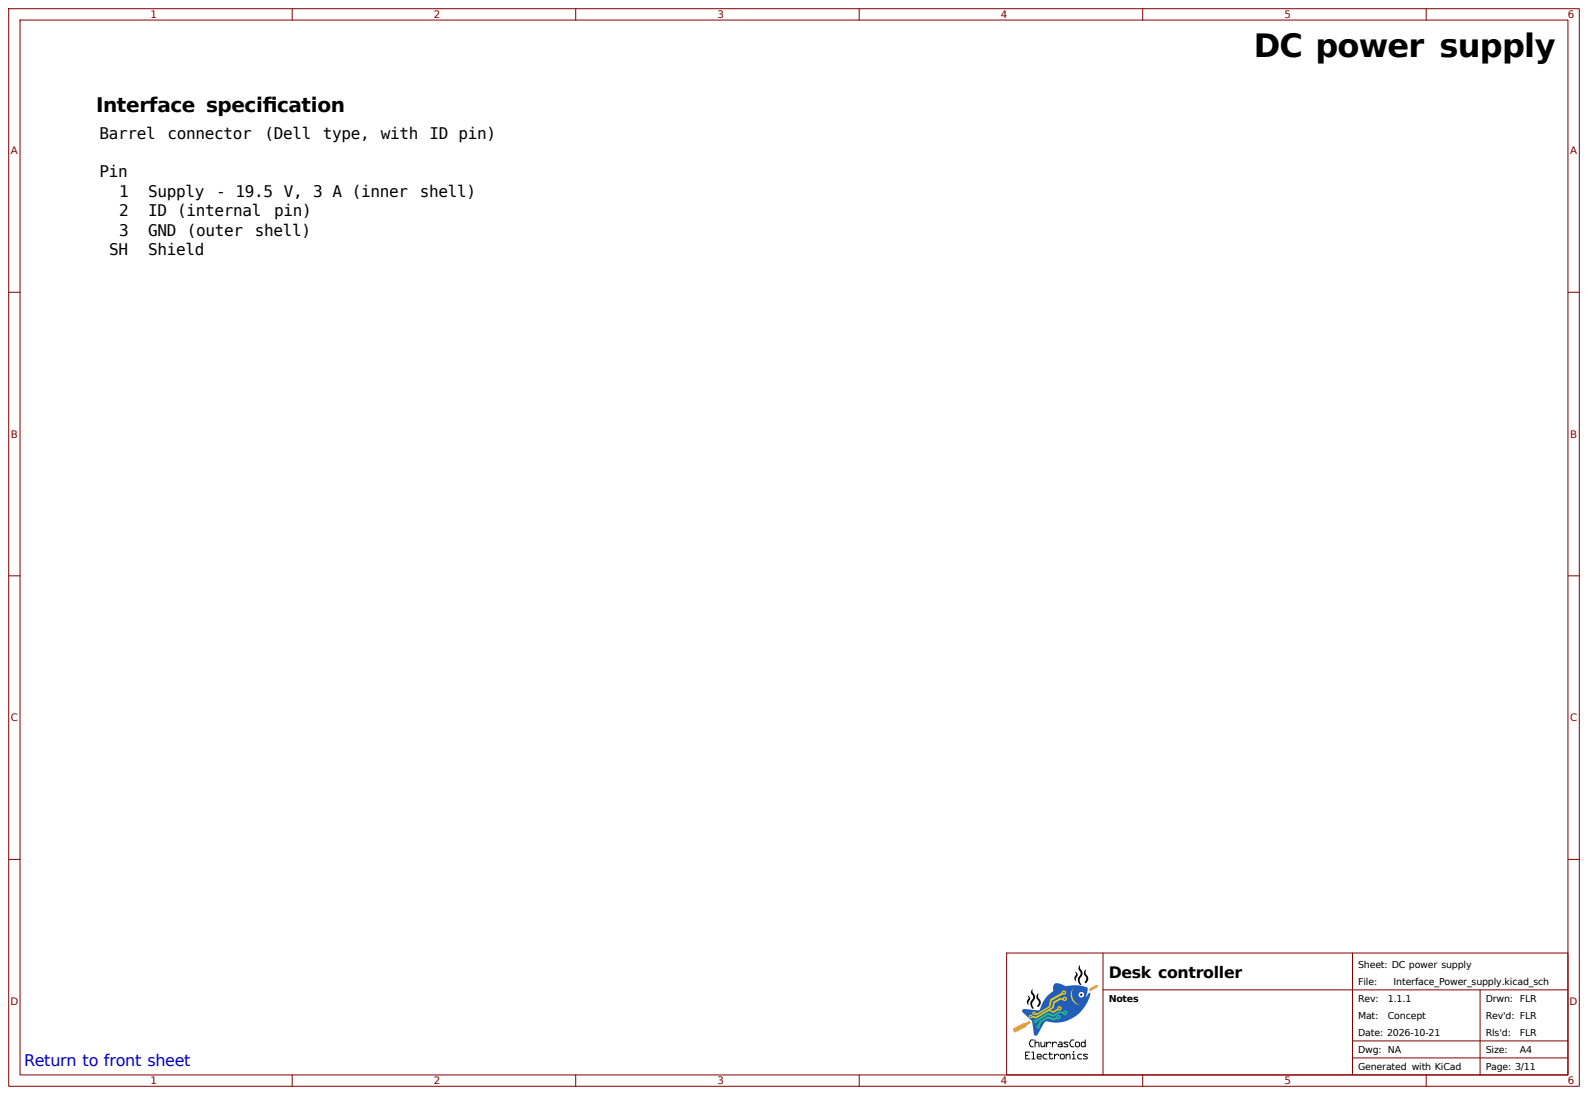
[picture p45: page 3]

Interface specification
Barrel connector (Dell type, with ID pin)

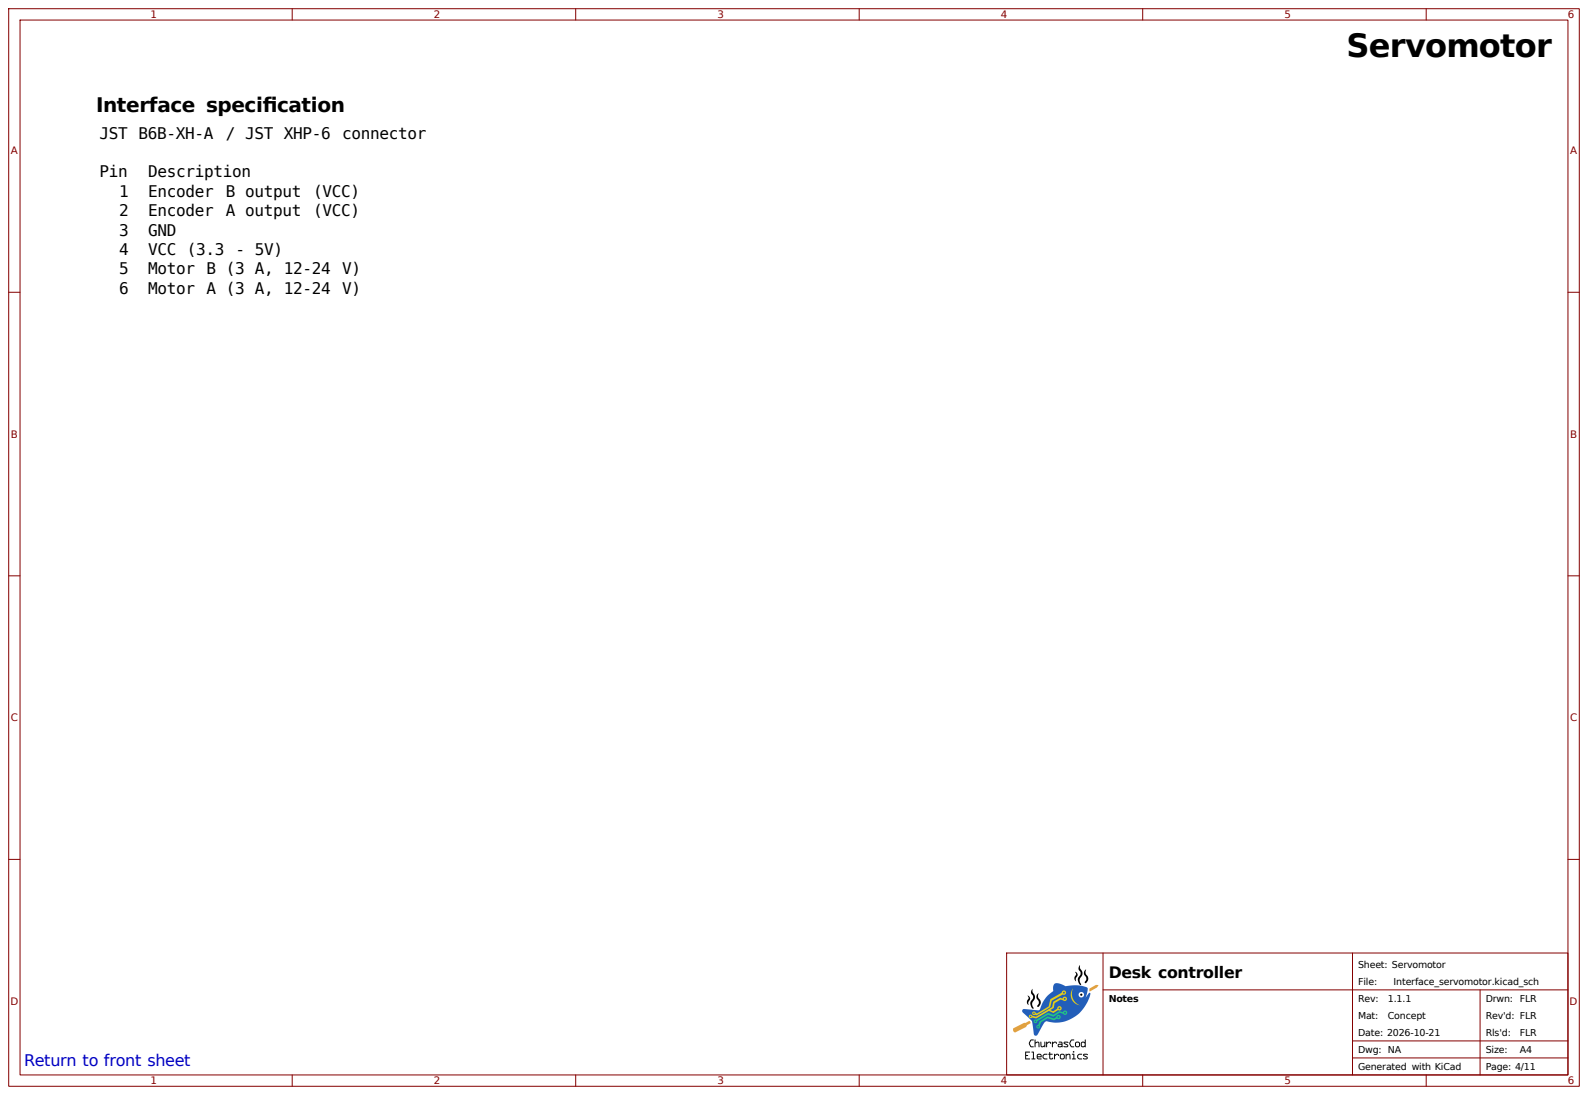
[picture p46: page 4]

Interface specification
JST B6B-XH-A / JST XHP-6 connector

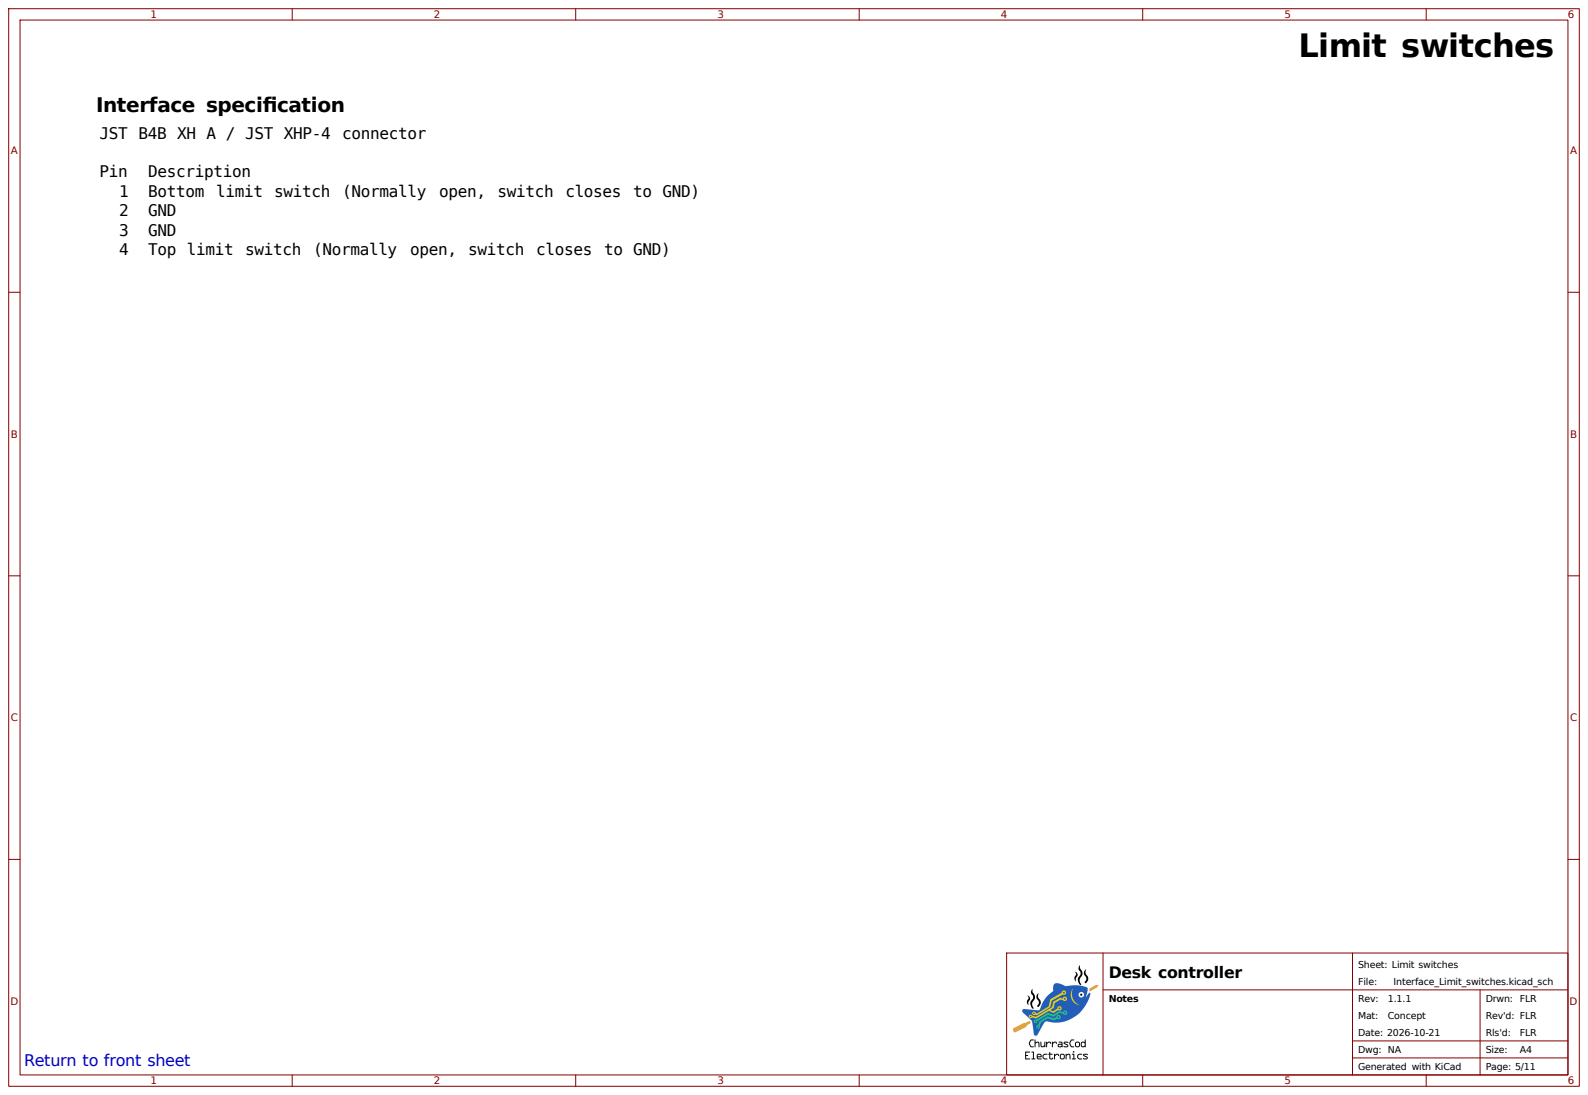
[picture p47: page 5]

Interface specification
JST B4B XH A / JST XHP-4 connector

Pin Description
1 Bottom limit switch (Normally open, switch closes to GND)
2 GND
3 GND
4 Top limit switch (Normally open, switch closes to GND)

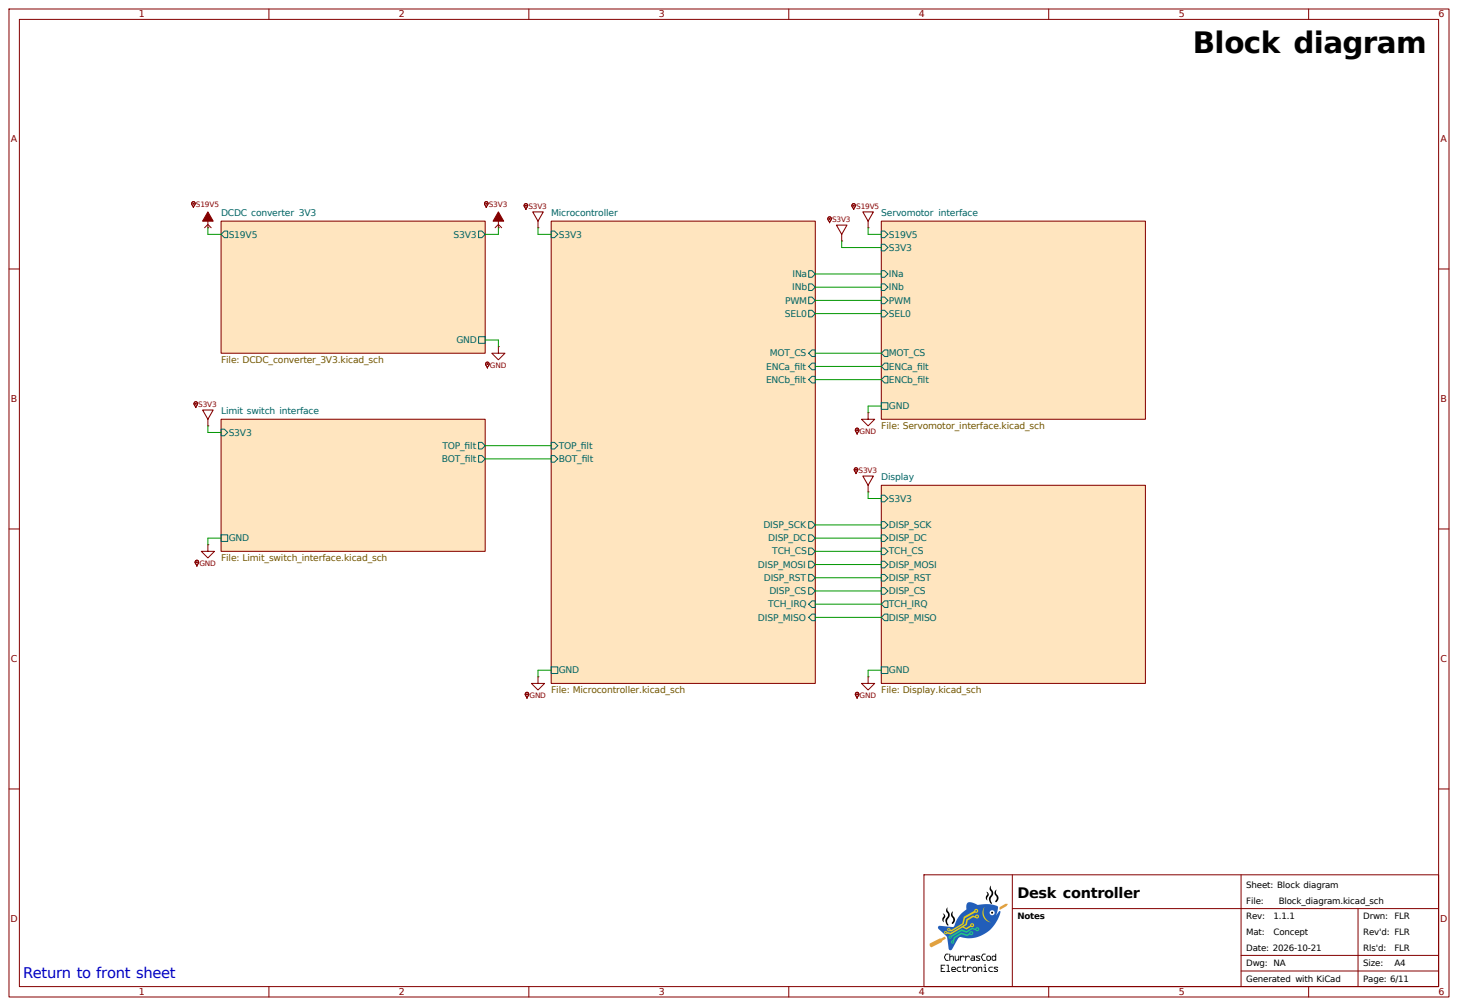
[picture p48: page 6]

INb Microcontroller File: Microcontroller.kicad_sch S3V3

S3V3 Return to front sheet

File: Sheet: Block diagram

Notes | Block_diagram.kicad_sch Dwg: NA Date: 2026-10-21 Generated with KiCad Rev: Concept | Size: Page: 6/11 Drwn: Rev'd: FLR FLR FLR

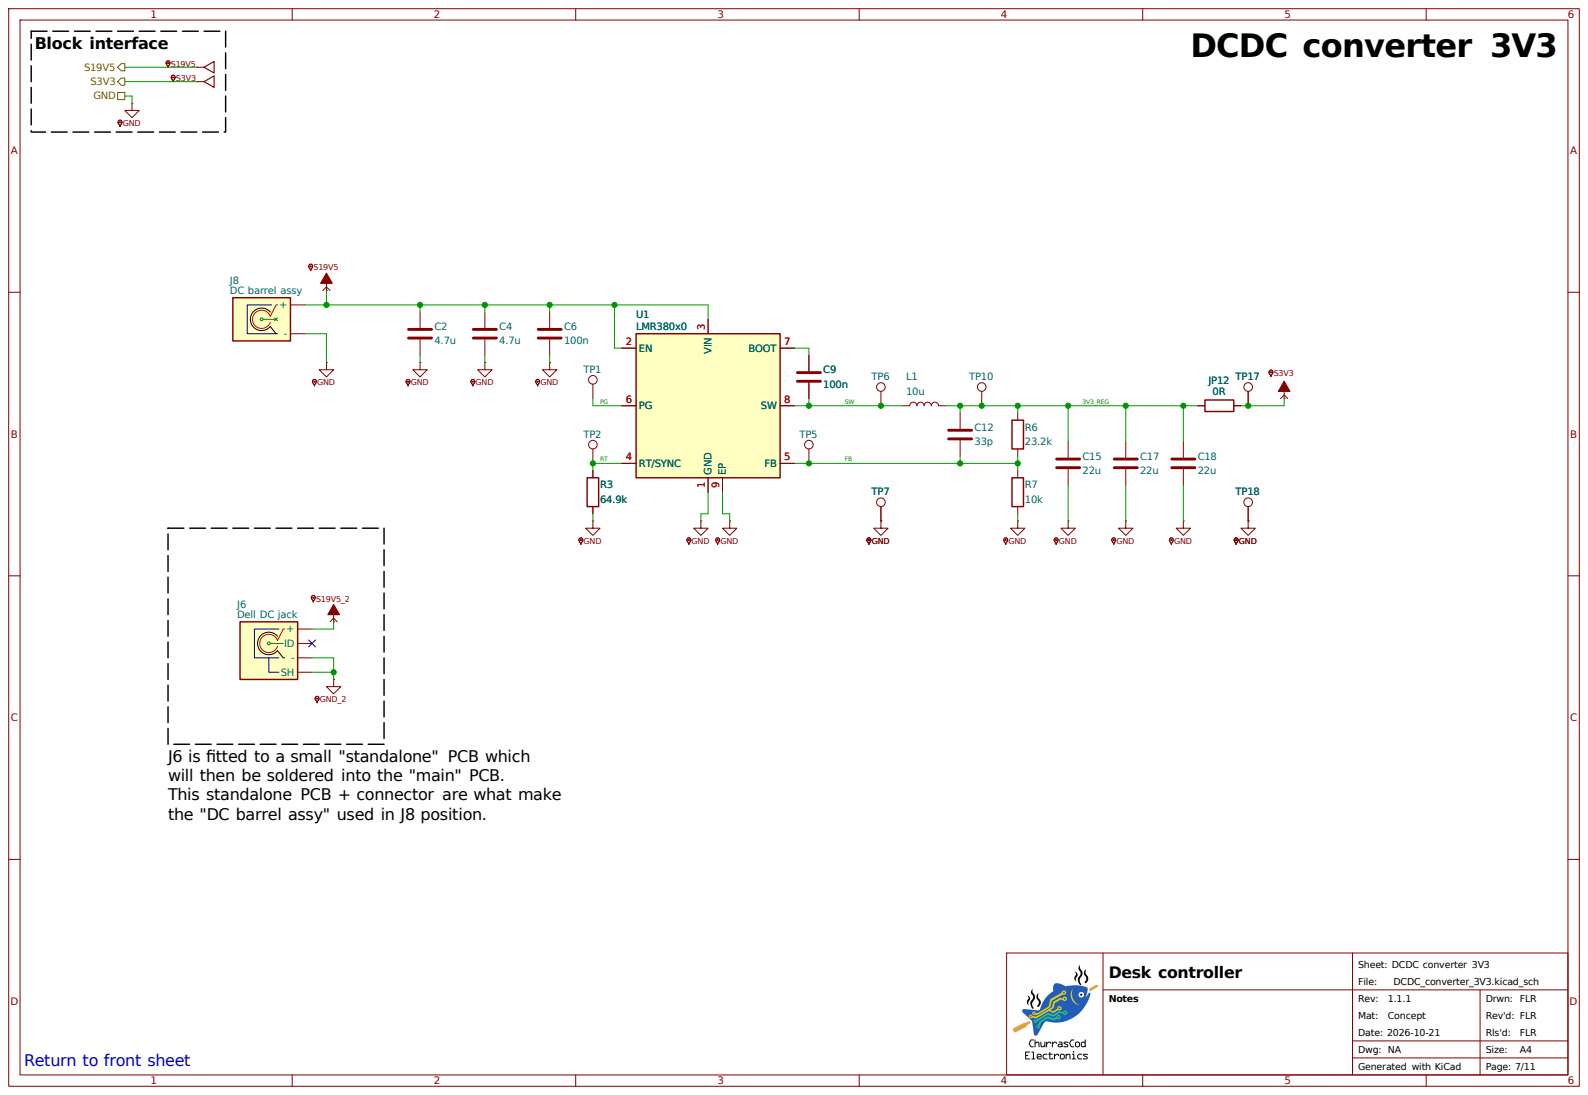
[picture p49: page 7]

J6 is fitted to a small "standalone" PCB which
will then be soldered into the "main" PCB.
This standalone PCB + connector are what make
the "DC barrel assy" used in J8 position.

Drwn: Rev'd: FLR DCDC_converter_3V3.kicad_sch Dwg: NA

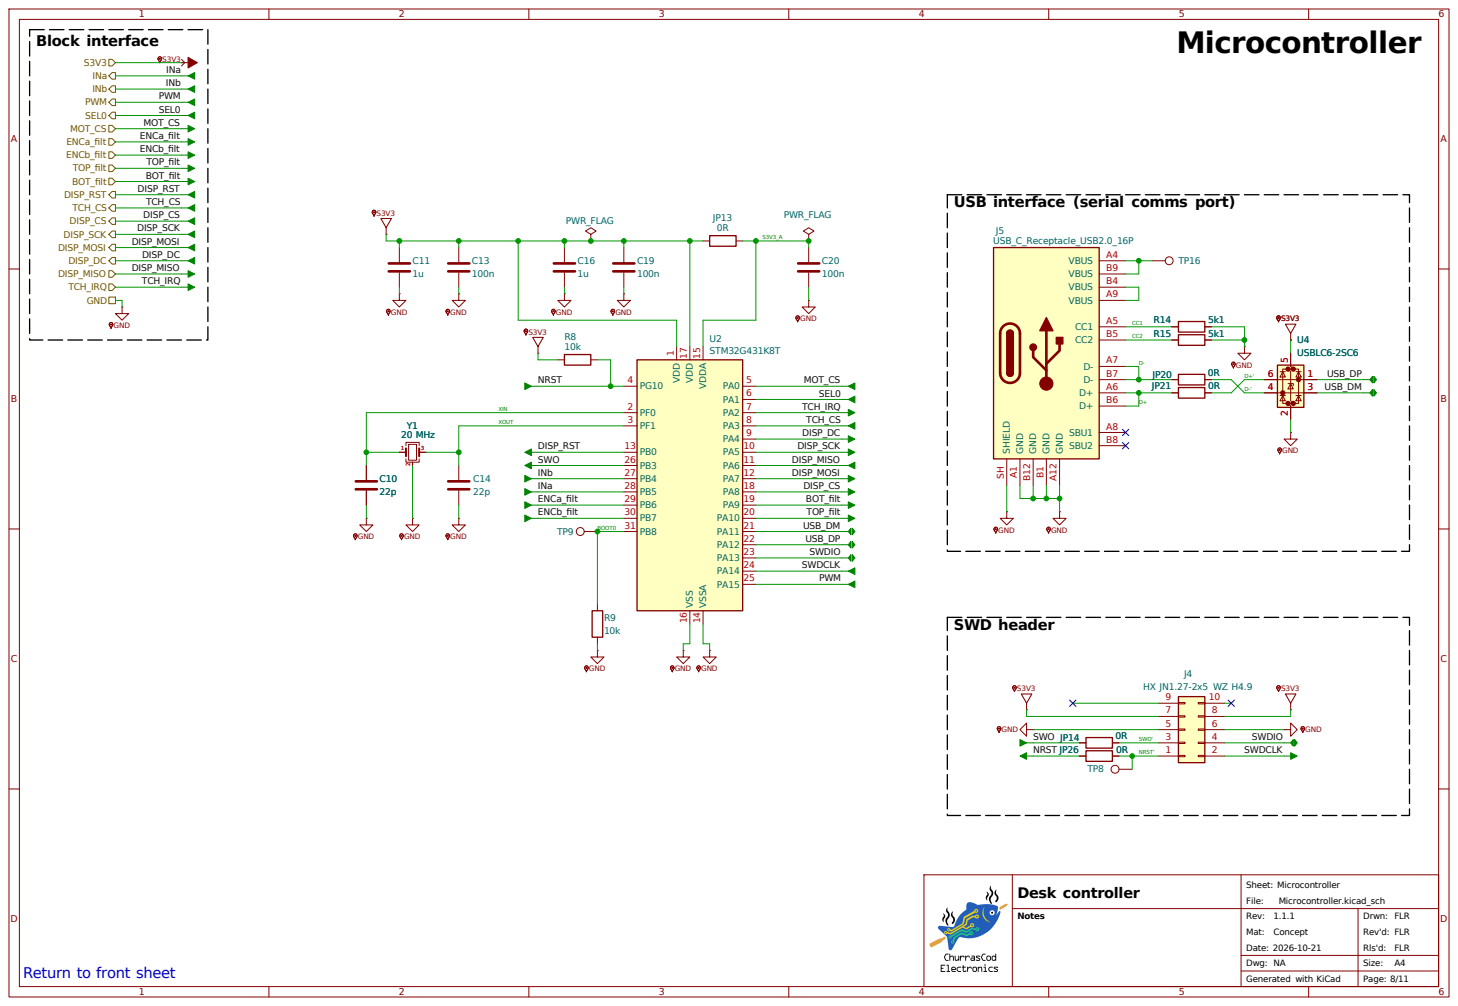
[picture p50: page 8]

USB interface (serial comms port)

Drwn: Rev'd: FLR Microcontroller.kicad_sch Dwg: NA

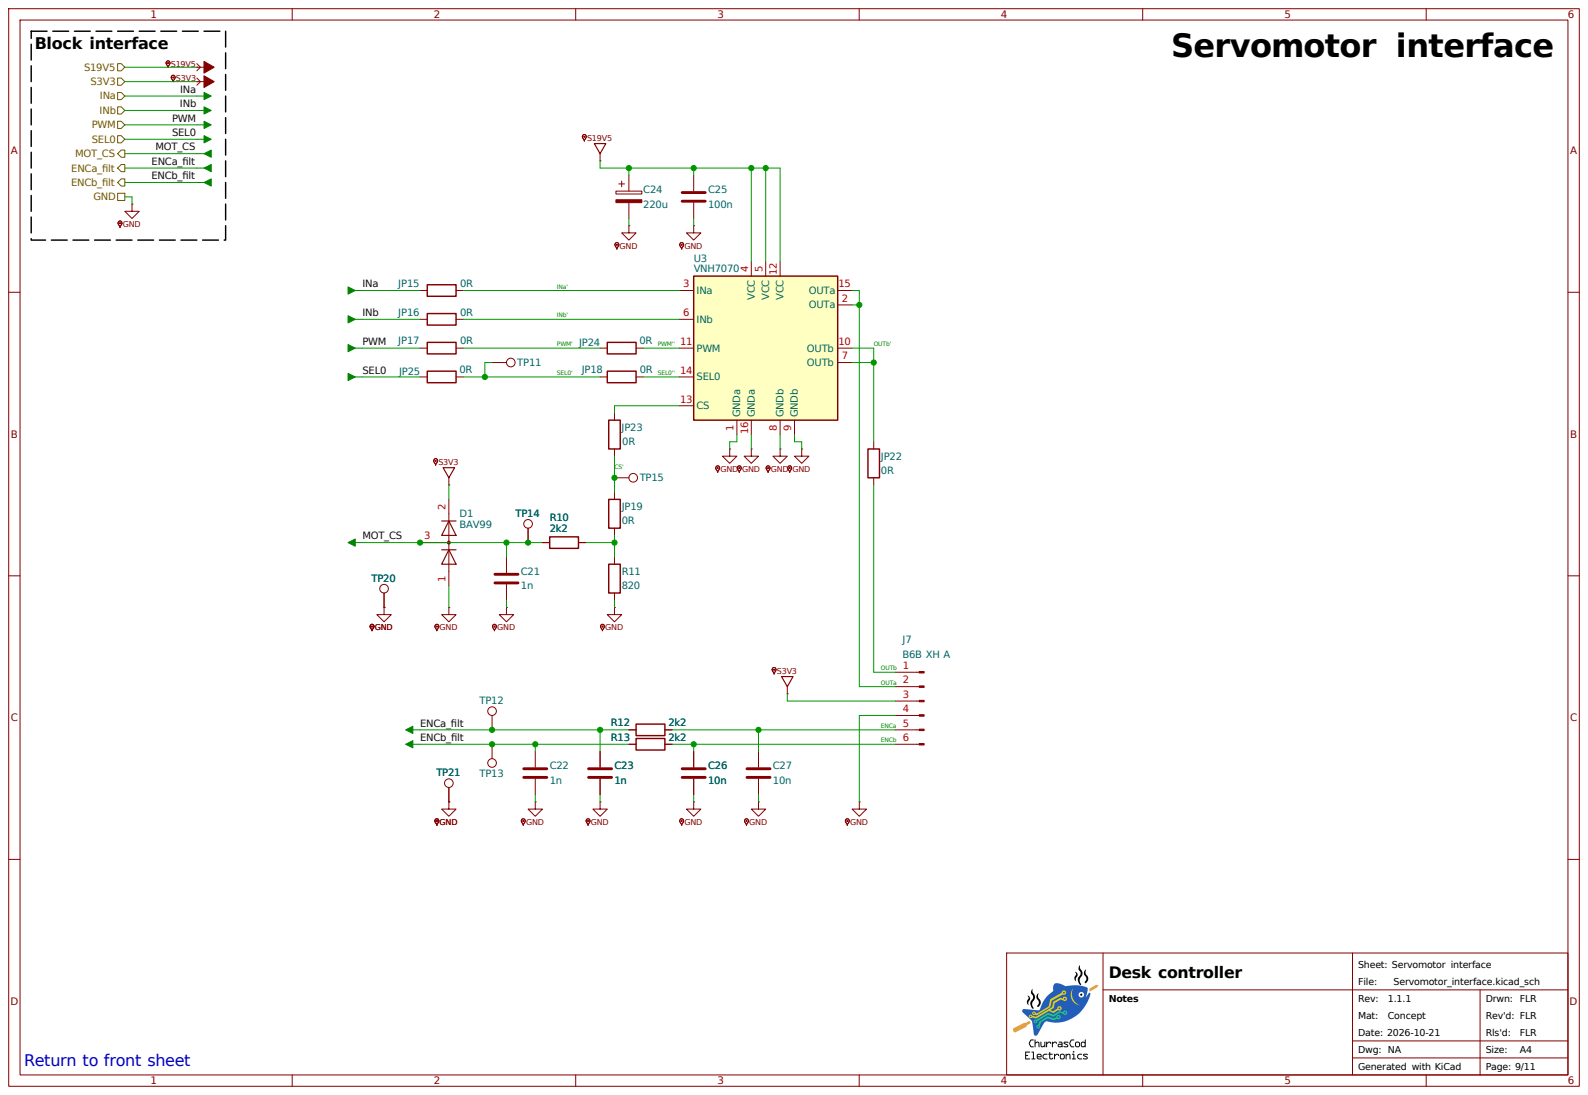
[picture p51: page 9]

GND GND GND GND GND

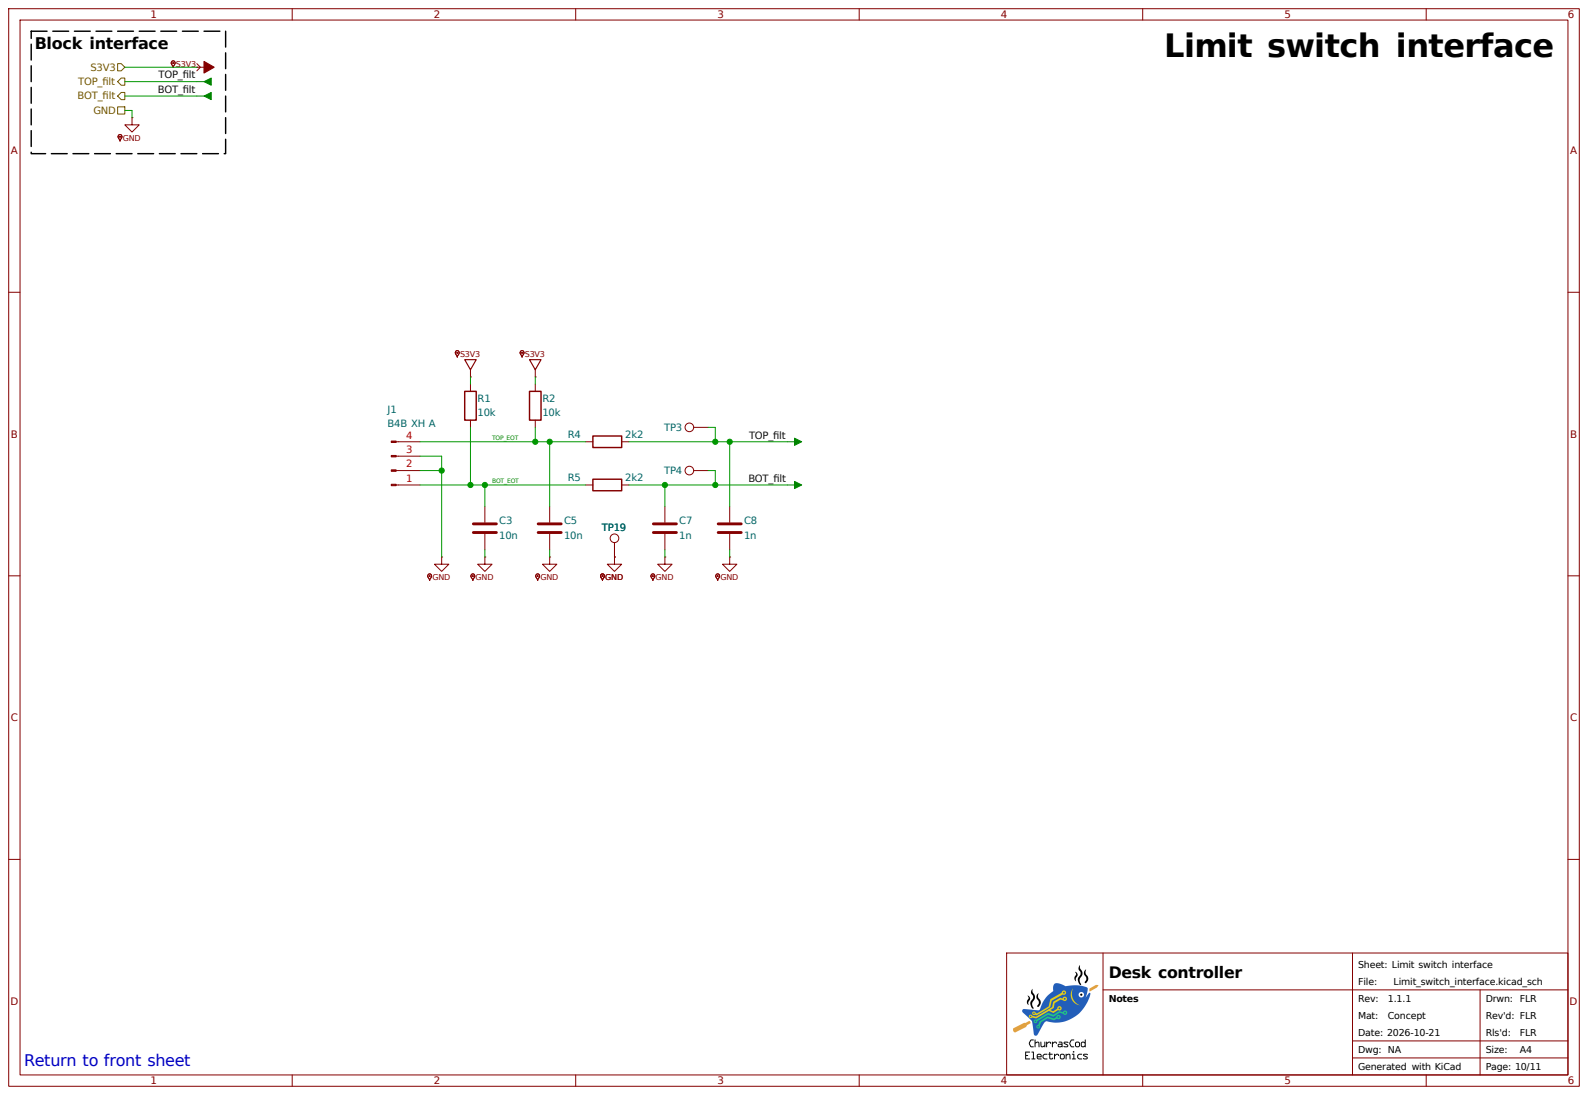
[picture p52: page 10]

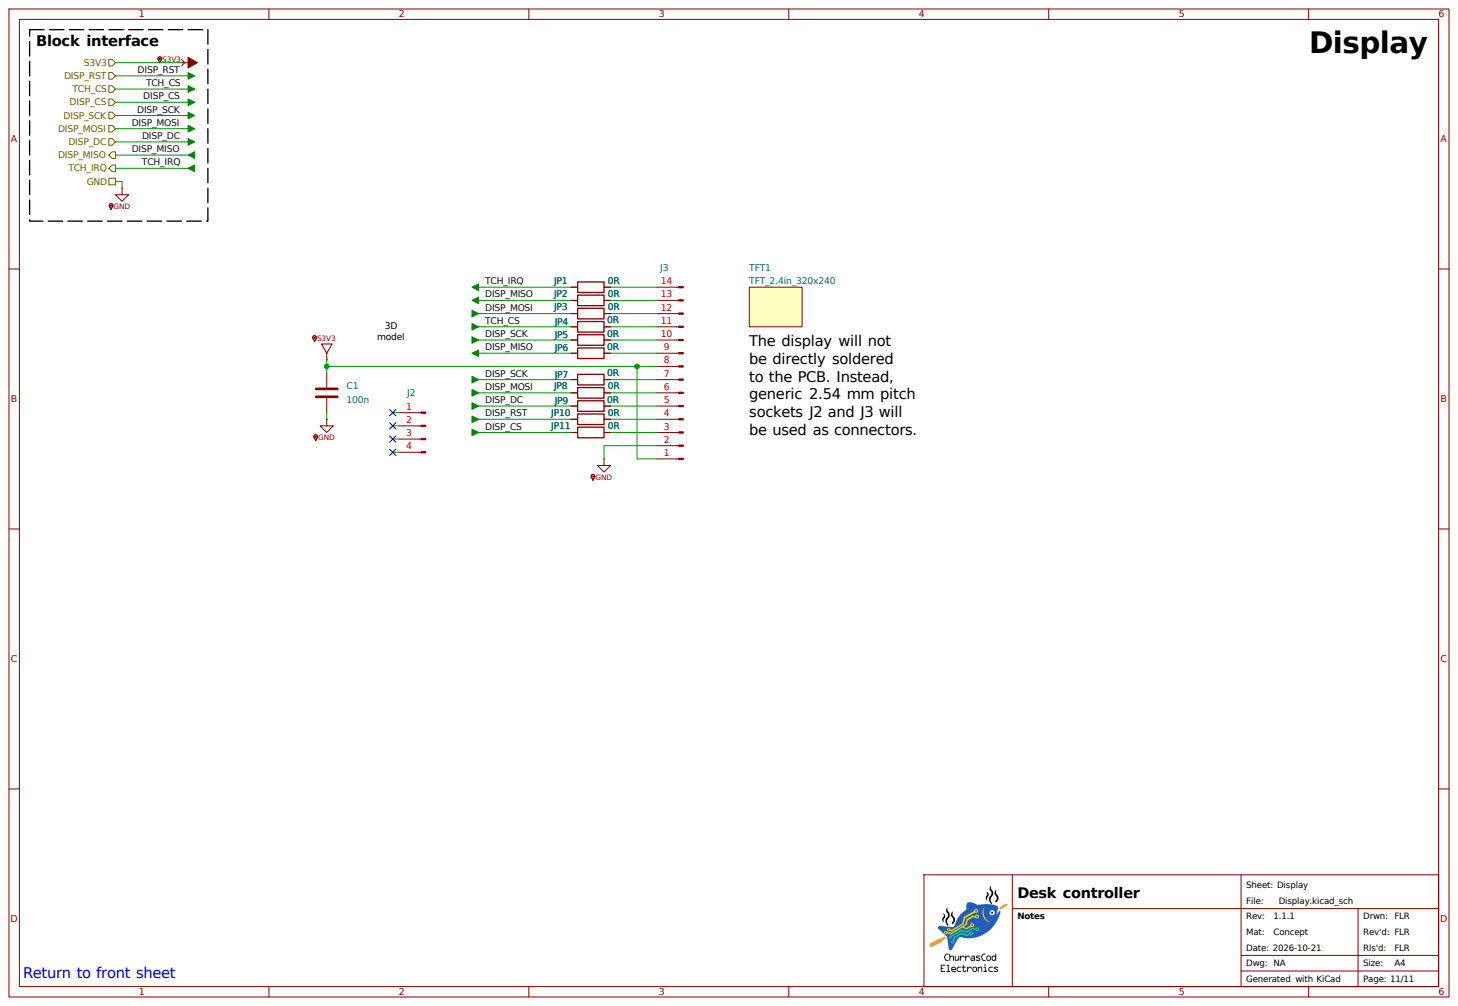
[picture p53: page 11]

The display will not
be directly soldered
to the PCB. Instead,
generic 2.54 mm pitch
sockets J2 and J3 will
be used as connectors.

Drwn: Rev'd: FLR Display.kicad_sch Dwg: NA
