FLRHW/Desk_controller/output/assembly/Desk_controller-testpoints.pdf

Desk controller testpoint drawing | Top testpoints (scale 1:1)

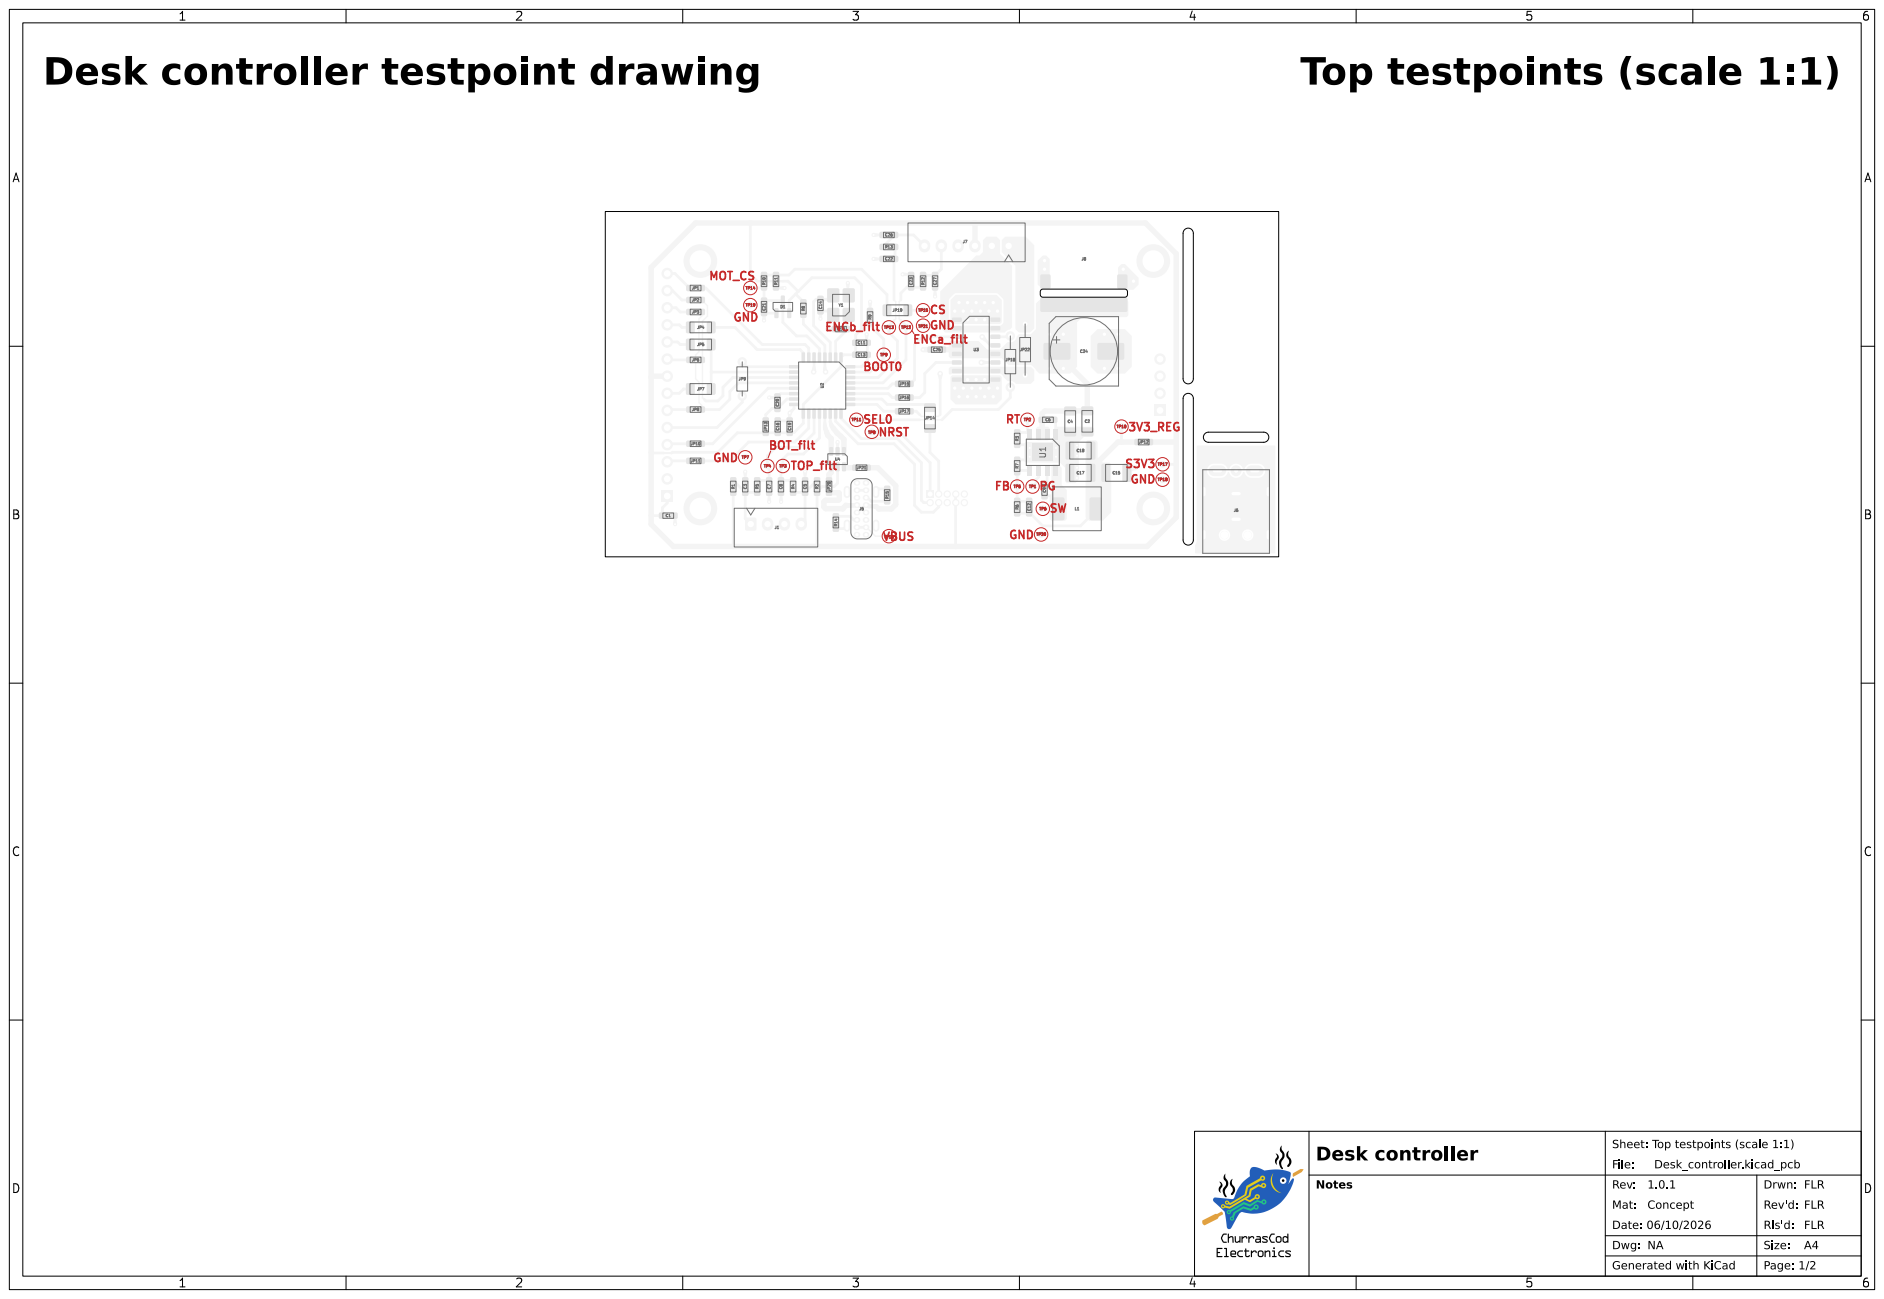
[picture p54: page 1]

# Bottom testpoints (scale 1:1)

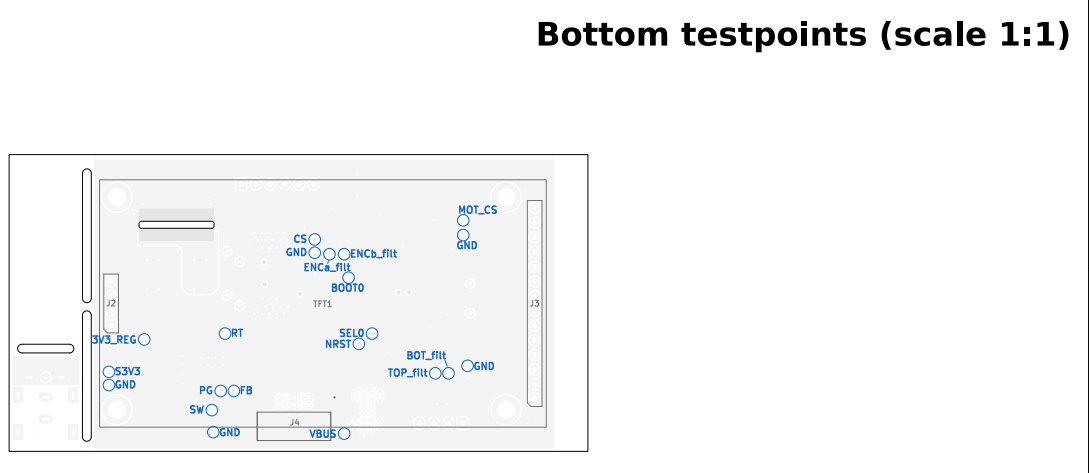
[picture p55: page 2]
Desk_controller.kicad_pcb; FLR; Rev'd:; Drwn:; Desk controller; Rls'd:; Concept; Notes; Size:; 3V3_REG; GND; VBUS; NRST; SEL0; TOP_filt; BOT_filt; ENCa_filt; BOOT0; MOT_CS; ENCb_filt; TFT1

Sheet: Bottom testpoints (scale 1:1)
File:
Rev:
Mat:
Date: 06/10/2026
Dwg: NA
Generated with KiCad
