FLRHW/Desk_controller/Desk_controller.kicad_pcb

## KiCad design Desk_controller.kicad_pcb (2026-10-15)

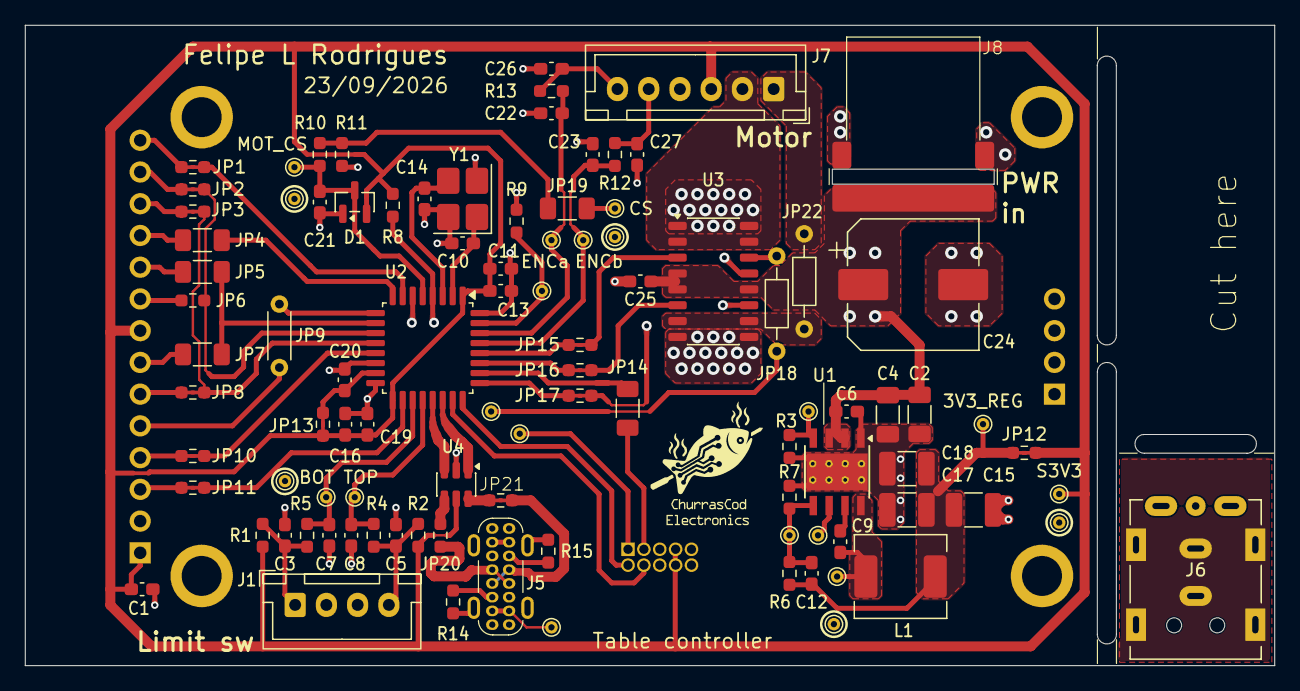
[picture p56: board Desk_controller.kicad_pcb from above]

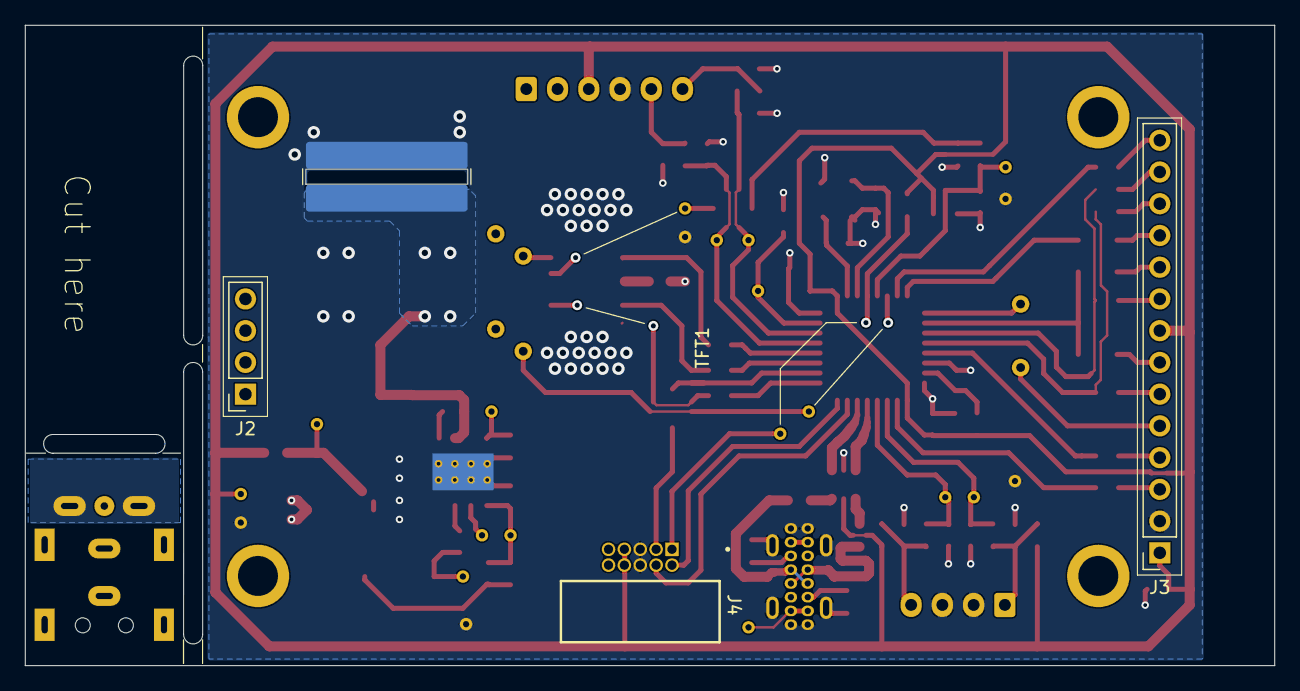
[picture p57: board Desk_controller.kicad_pcb from below]

Board: 2 copper layers, 100.0 x 51.2 mm, 105 parts (7 on the bottom side), 74 nets.

Parts:
C1, C6, C9, C13, C19, C20, C25: 100n; C_0603_1608Metric_Pad1.08x0.95mm_HandSolder
C2, C4: 4.7u; C_1206_3216Metric_Pad1.33x1.80mm_HandSolder
C3, C5, C26, C27: 10n; C_0603_1608Metric_Pad1.08x0.95mm_HandSolder
C7, C8, C21, C22, C23: 1n; C_0603_1608Metric_Pad1.08x0.95mm_HandSolder
C10, C14: 22p; C_0603_1608Metric_Pad1.08x0.95mm_HandSolder
C11, C16: 1u; C_0603_1608Metric_Pad1.08x0.95mm_HandSolder
C12: 33p; C_0603_1608Metric_Pad1.08x0.95mm_HandSolder
C15, C17, C18: 22u; C_1210_3225Metric_Pad1.33x2.70mm_HandSolder
C24: 220u; CP_Elec_10x10
D1: BAV99; SOT-23
J1: B4B XH A; JST_XH_B4B-XH-A_1x04_P2.50mm_Vertical
J2: 01x04 socket; PinSocket_1x04_P2.54mm_Vertical
J3: 01x14 socket; PinSocket_1x14_P2.54mm_Vertical
J4: HX JN1.27-2x5 WZ H4.9; JN1.27-2x5 WZ H4.9
J5: USB_C_Receptacle_USB2.0_16P; USB_C_socket_16P_vertical
J6: Dell DC jack
J7: B6B XH A; JST_XH_B6B-XH-A_1x06_P2.50mm_Vertical
J8: DC barrel assy; Dell_barrel_assy
JP1, JP2, JP3, JP8, JP10, JP11, JP12, JP13, JP15, JP16, JP17, JP21: 0R; Jumper_0603
JP4, JP5, JP7, JP14, JP19: 0R; R_1206_3216Metric_Pad1.30x1.75mm_HandSolder
JP6, JP20: 0R; R_0603_1608Metric_Pad0.98x0.95mm_HandSolder
JP9: 0R; R_Axial_DIN0204_L3.6mm_D1.6mm_P5.08mm_Horizontal
JP18, JP22: 0R; R_Axial_DIN0204_L3.6mm_D1.6mm_P7.62mm_Horizontal
JP23: 0R; Wire_9.603mm
JP24: 0R; Wire_6.310mm
JP25: 0R; Wire_9.532mm
JP26: 0R; Wire_6.853x8.890mm
L1: 10u; L_Bourns_SRP6540
R1, R2, R7, R8, R9: 10k; R_0603_1608Metric_Pad0.98x0.95mm_HandSolder
R3: 64.9k; R_0603_1608Metric_Pad0.98x0.95mm_HandSolder
R4, R5, R10, R12, R13: 2k2; R_0603_1608Metric_Pad0.98x0.95mm_HandSolder
R6: 23.2k; R_0603_1608Metric_Pad0.98x0.95mm_HandSolder
R11: 820; R_0603_1608Metric_Pad0.98x0.95mm_HandSolder
R14, R15: 5k1; R_0603_1608Metric_Pad0.98x0.95mm_HandSolder
TFT1: TFT_2.4in_320x240; Display_240x320_ILI9341_2.4in_no_pads
TP1, TP2, TP3, TP4, TP5, TP6, TP7, TP8, TP9, TP10, TP11, TP12, TP13, TP14, TP15, TP16, TP17, TP18, TP19, TP20, TP21: TestPoint; TestPoint_THTPad_D1.0mm_Drill0.5mm
U1: LMR380x0; Texas_HSOP-8-1EP_3.9x4.9mm_P1.27mm_ThermalVias_w_step
U2: STM32G431K8T; LQFP-32_7x7mm_P0.8mm
U3: VNH7070; JEITA_SOIC-16_3.9x9.9mm_P1.27mm
U4: USBLC6-2SC6; SOT-23-6
Y1: 20 MHz; Crystal_SMD_3225-4Pin_3.2x2.5mm_HandSoldering

Connections:
/System overview/Block diagram/DCDC converter 3V3/3V3_REG: C12.1, C15.1, C17.1, C18.1, JP12.1, L1.2, R6.1, TP10.1 (1_1)
/System overview/Block diagram/DCDC converter 3V3/FB: C12.2, R6.2, R7.1, TP5.1 (1_1), U1.5 (FB)
/System overview/Block diagram/DCDC converter 3V3/GND_2: J6.3 (-), J6.SH
/System overview/Block diagram/DCDC converter 3V3/PG: TP1.1 (1_1), U1.6 (PG)
/System overview/Block diagram/DCDC converter 3V3/RT: R3.1, TP2.1 (1_1), U1.4 (RT/SYNC)
/System overview/Block diagram/DCDC converter 3V3/SW: C9.2, L1.1, TP6.1 (1_1), U1.8 (SW)
/System overview/Block diagram/Display/DISP_CS: JP11.1, U2.18 (PA8)
/System overview/Block diagram/Display/DISP_DC: JP9.1, U2.9 (PA4)
/System overview/Block diagram/Display/DISP_MISO: JP2.1, JP6.1, U2.11 (PA6)
/System overview/Block diagram/Display/DISP_MOSI: JP3.1, JP8.1, U2.12 (PA7)
/System overview/Block diagram/Display/DISP_RST: JP10.1, U2.13 (PB0)
/System overview/Block diagram/Display/DISP_SCK: JP5.1, JP7.1, U2.10 (PA5)
/System overview/Block diagram/Display/TCH_CS: JP4.1, U2.8 (PA3)
/System overview/Block diagram/Display/TCH_IRQ: JP1.1, U2.7 (PA2)
/System overview/Block diagram/GND: C1.2, C2.2, C3.2, C4.2, C5.2, C6.2, C7.2, C8.2, C10.2, C11.2, C13.2, C14.2, C15.2, C16.2, C17.2, C18.2, C19.2, C20.2, C21.2, C22.2, C23.2, C24.2, C25.2, C26.2, C27.2, D1.1 (K), J1.2, J1.3, J3.2, J4.5, J4.6, J5.A1 (GND), J5.A12 (GND), J5.B1 (GND), J5.B12 (GND), J5.SH (SHIELD), J7.4, J8.2 (-), R3.2, R7.2, R9.2, R11.2, R14.2, R15.2, TP7.1 (1_1), TP18.1 (1_1), TP19.1 (1_1), TP20.1 (1_1), TP21.1 (1_1), U1.1 (GND), U1.9 (EP), U2.14 (VSSA), U2.16 (VSS), U2.32 (VSS), U3.1 (GNDa), U3.8 (GNDb), U3.9 (GNDb), U3.16 (GNDa), U4.2 (GND), Y1.2 (G), Y1.4 (G)
/System overview/Block diagram/Limit switch interface/BOT_EOT: C3.1, J1.1, R1.2, R5.1
/System overview/Block diagram/Limit switch interface/BOT_filt: C7.1, R5.2, TP4.1 (1_1), U2.19 (PA9)
/System overview/Block diagram/Limit switch interface/TOP_EOT: C5.1, J1.4, R2.2, R4.1
/System overview/Block diagram/Limit switch interface/TOP_filt: C8.1, R4.2, TP3.1 (1_1), U2.20 (PA10)
/System overview/Block diagram/Microcontroller/BOOT0: R9.1, TP9.1 (1_1), U2.31 (PB8)
/System overview/Block diagram/Microcontroller/CC1: J5.A5 (CC1), R14.1
/System overview/Block diagram/Microcontroller/CC2: J5.B5 (CC2), R15.1
/System overview/Block diagram/Microcontroller/D+: J5.A6 (D+), J5.B6 (D+), JP21.1
/System overview/Block diagram/Microcontroller/D+': JP21.2, U4.6 (I/O1)
/System overview/Block diagram/Microcontroller/D-: J5.A7 (D-), J5.B7 (D-), JP20.1
/System overview/Block diagram/Microcontroller/D-': JP20.2, U4.4 (I/O2)
/System overview/Block diagram/Microcontroller/ENCa_filt: C23.1, R12.1, TP12.1 (1_1), U2.29 (PB6)
/System overview/Block diagram/Microcontroller/ENCb_filt: C22.1, R13.1, TP13.1 (1_1), U2.30 (PB7)
/System overview/Block diagram/Microcontroller/INa: JP15.1, U2.28 (PB5)
/System overview/Block diagram/Microcontroller/INb: JP16.1, U2.27 (PB4)
/System overview/Block diagram/Microcontroller/MOT_CS: C21.1, D1.3 (K), R10.1, TP14.1 (1_1), U2.5 (PA0)
/System overview/Block diagram/Microcontroller/NRST: JP26.1, R8.2, U2.4 (PG10)
/System overview/Block diagram/Microcontroller/NRST': J4.1, JP26.2, TP8.1 (1_1)
/System overview/Block diagram/Microcontroller/PWM: JP17.1, U2.25 (PA15)
/System overview/Block diagram/Microcontroller/S3V3_A: C20.1, JP13.2, U2.15 (VDDA)
/System overview/Block diagram/Microcontroller/SEL0: JP25.1, U2.6 (PA1)
/System overview/Block diagram/Microcontroller/SWDCLK: J4.2, U2.24 (PA14)
/System overview/Block diagram/Microcontroller/SWDIO: J4.4, U2.23 (PA13)
/System overview/Block diagram/Microcontroller/SWO: JP14.1, U2.26 (PB3)
/System overview/Block diagram/Microcontroller/SWO': J4.3, JP14.2
/System overview/Block diagram/Microcontroller/USB_DM: U2.21 (PA11), U4.3 (I/O2)
/System overview/Block diagram/Microcontroller/USB_DP: U2.22 (PA12), U4.1 (I/O1)
/System overview/Block diagram/Microcontroller/XIN: C10.1, U2.2 (PF0), Y1.1
/System overview/Block diagram/Microcontroller/XOUT: C14.1, U2.3 (PF1), Y1.3
/System overview/Block diagram/S3V3: C1.1, C11.1, C13.1, C16.1, C19.1, D1.2 (A), J3.1, J3.8, J4.7, J4.8, J7.3, JP12.2, JP13.1, R1.1, R2.1, R8.1, TP17.1 (1_1), U2.1 (VDD), U2.17 (VDD), U4.5 (VBUS)
/System overview/Block diagram/S19V5: C2.1, C4.1, C6.1, C24.1, C25.1, J8.1 (+), U1.2 (EN), U1.3 (VIN), U3.4 (VCC), U3.5 (VCC), U3.12 (VCC)
/System overview/Block diagram/Servomotor interface/CS': JP19.2, JP23.1, TP15.1 (1_1)
/System overview/Block diagram/Servomotor interface/ENCa: C27.1, J7.5, R12.2
/System overview/Block diagram/Servomotor interface/ENCb: C26.1, J7.6, R13.2
/System overview/Block diagram/Servomotor interface/INa': JP15.2, U3.3 (INa)
/System overview/Block diagram/Servomotor interface/INb': JP16.2, U3.6 (INb)
/System overview/Block diagram/Servomotor interface/OUTa: J7.2, U3.2 (OUTa), U3.15 (OUTa)
/System overview/Block diagram/Servomotor interface/OUTb: J7.1, JP22.1
/System overview/Block diagram/Servomotor interface/OUTb': JP22.2, U3.7 (OUTb), U3.10 (OUTb)
/System overview/Block diagram/Servomotor interface/PWM': JP17.2, JP24.1
/System overview/Block diagram/Servomotor interface/PWM'': JP24.2, U3.11 (PWM)
/System overview/Block diagram/Servomotor interface/SEL0': JP18.2, JP25.2, TP11.1 (1_1)
/System overview/Block diagram/Servomotor interface/SEL0'': JP18.1, U3.14 (SEL0)
unnamed: J3.3, JP11.2
unnamed: J3.4, JP10.2
unnamed: J3.5, JP9.2
unnamed: J3.6, JP8.2
unnamed: J3.7, JP7.2
unnamed: J3.9, JP6.2
unnamed: J3.10, JP5.2
unnamed: J3.11, JP4.2
unnamed: J3.12, JP3.2
unnamed: J3.13, JP2.2
unnamed: J3.14, JP1.2
unnamed: J5.A4 (VBUS), J5.B9 (VBUS), TP16.1 (1_1)
unnamed: J5.A9 (VBUS), J5.B4 (VBUS)
unnamed: JP19.1, R10.2, R11.1
unnamed: C9.1, U1.7 (BOOT)
unnamed: JP23.2, U3.13 (CS)
