FLRHW/Desk_controller/(commit log)

2026-10-14 Create project from FLRHW KiCad Starter
    [Block_diagram.kicad_sch, Childsheet_1_example.kicad_sch, Childsheet_2_example.kicad_sch, Desk_controller.kicad_pcb, Desk_controller.kicad_sch, Interface_childsheet_0_example.kicad_sch, System_overview.kicad_sch]
2026-10-14 Update KiBot outputs
    [Desk_controller-(L1-L2)_drill_table.csv, Desk_controller-3D.step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]
2026-10-14 starting project migration
    [Block_diagram.kicad_sch, Childsheet_1_example.kicad_sch, Childsheet_2_example.kicad_sch, DCDC_converter_3V3.kicad_sch, Desk_controller.kicad_pcb, Desk_controller.kicad_sch, Display.kicad_sch, Interface_Limit_switches.kicad_sch]
2026-10-15 erc clear
    [Desk_controller.kicad_pcb, Microcontroller.kicad_sch]
2026-10-15 drc clear
    [Desk_controller.kicad_pcb]
2026-10-15 Make project libraries and 3D models self-contained
    [Desk_controller.kicad_pcb]
2026-10-15 refining fab and assy docs
    [DCDC_converter_3V3.kicad_sch, Desk_controller.kicad_pcb]
2026-10-15 resizing pictures
    [Desk_controller.kicad_pcb]
2026-10-15 add TP layer
    [Desk_controller.kicad_pcb, Desk_controller.kicad_sch, System_overview.kicad_sch]
2026-10-16 ready for release
    [Desk_controller.kicad_sch]
2026-10-21 Document revision 1.1.1: container CI and Pages publishing
    [Block_diagram.kicad_sch, DCDC_converter_3V3.kicad_sch, Desk_controller.kicad_sch, Display.kicad_sch, Interface_Limit_switches.kicad_sch, Interface_Power_supply.kicad_sch, Interface_servomotor.kicad_sch, Limit_switch_interface.kicad_sch]
